UrbanSmartGrid/IRON_CASE_SWITCH/HW/PCB_PROJECTS/ACTUAL/MCAD/Параметры платы/6-слойная сборка Резонит.png

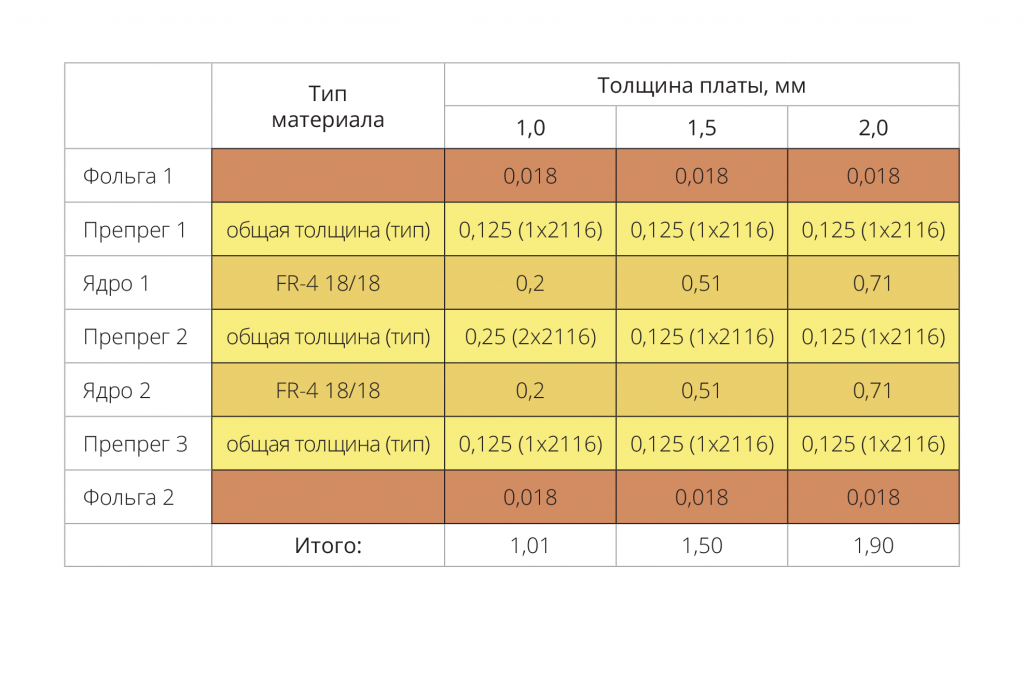
HW/PCB_PROJECTS/ACTUAL/MCAD/Параметры платы/6-слойная сборка Резонит.png
