UrbanSmartGrid/IRON_CASE_SWITCH/HW/PCB_PROJECTS/ACTUAL/MCAD/Исходные данные/MODULE_4x100_Fx/Плата MODULE_4x100_Fx.STEP

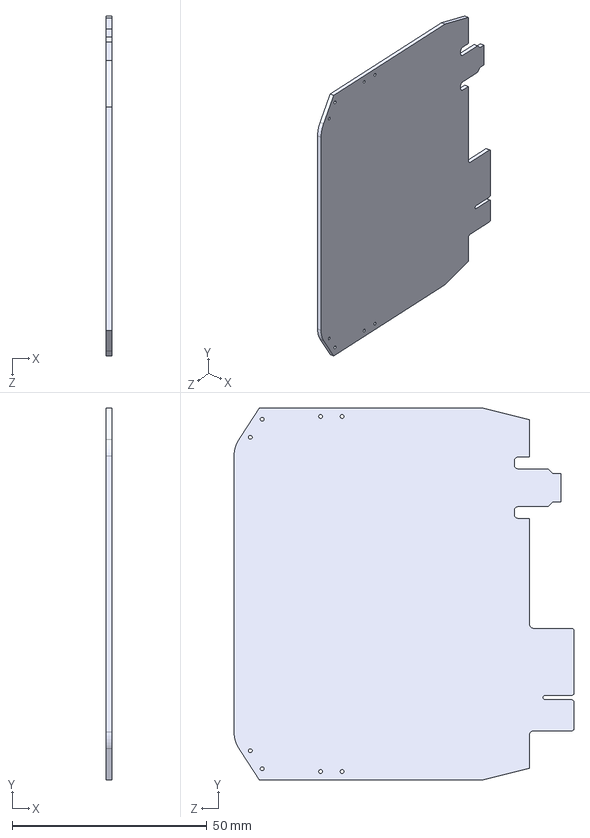
[picture p2: CAD file, 2021-02-21]
HW/PCB_PROJECTS/ACTUAL/MCAD/Исходные данные/MODULE_4x100_Fx/Плата MODULE_4x100_Fx.STEP
1.42 x 95.5 x 87.3 mm
