UrbanSmartGrid/IRON_CASE_SWITCH/HW/PCB_PROJECTS/ACTUAL/MCAD/Исходные данные/MOTHER_BOARD/Плата MOTHER_BOARD.STEP

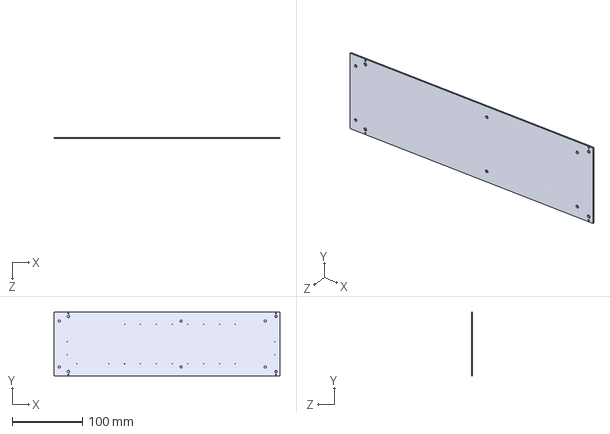
[picture p3: CAD file, 2021-02-21]
HW/PCB_PROJECTS/ACTUAL/MCAD/Исходные данные/MOTHER_BOARD/Плата MOTHER_BOARD.STEP
320.9 x 90.6 x 1.60 mm
