UrbanSmartGrid/IRON_CASE_SWITCH/HW/PCB_PROJECTS/ACTUAL/MCAD/Исходные данные/MODULE_4x100_Fx/WE 7466312.STEP

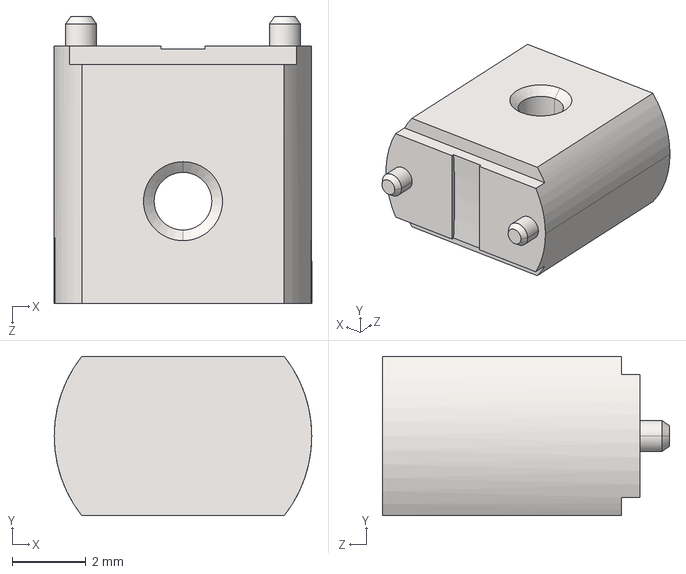
[picture p4: CAD file, 2021-02-21]
HW/PCB_PROJECTS/ACTUAL/MCAD/Исходные данные/MODULE_4x100_Fx/WE 7466312.STEP
7.00 x 4.33 x 7.80 mm
