UrbanSmartGrid/IRON_CASE_SWITCH/HW/PCB_PROJECTS/ACTUAL/MCAD/Исходные данные/MOTHER_BOARD/Направляющая печатной платы CGH-90.STEP

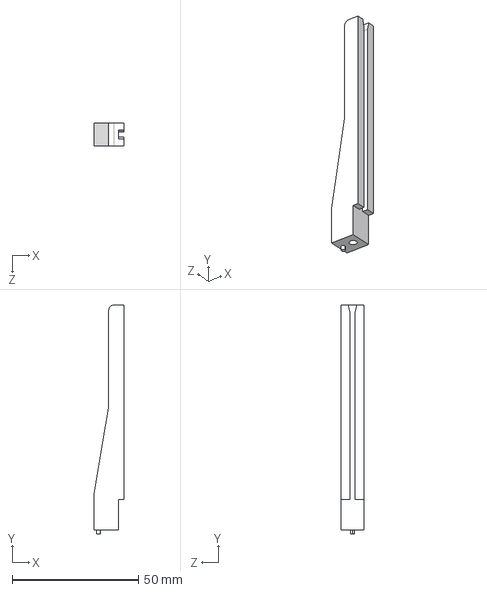
[picture p5: CAD file, 2021-02-21]
HW/PCB_PROJECTS/ACTUAL/MCAD/Исходные данные/MOTHER_BOARD/Направляющая печатной платы CGH-90.STEP
12.0 x 90.8 x 9.00 mm
