UrbanSmartGrid/IRON_CASE_SWITCH/HW/PCB_PROJECTS/ACTUAL/MCAD/Исходные данные/MOTHER_BOARD/Плата MOTHER_BOARD исх. дан..PDF

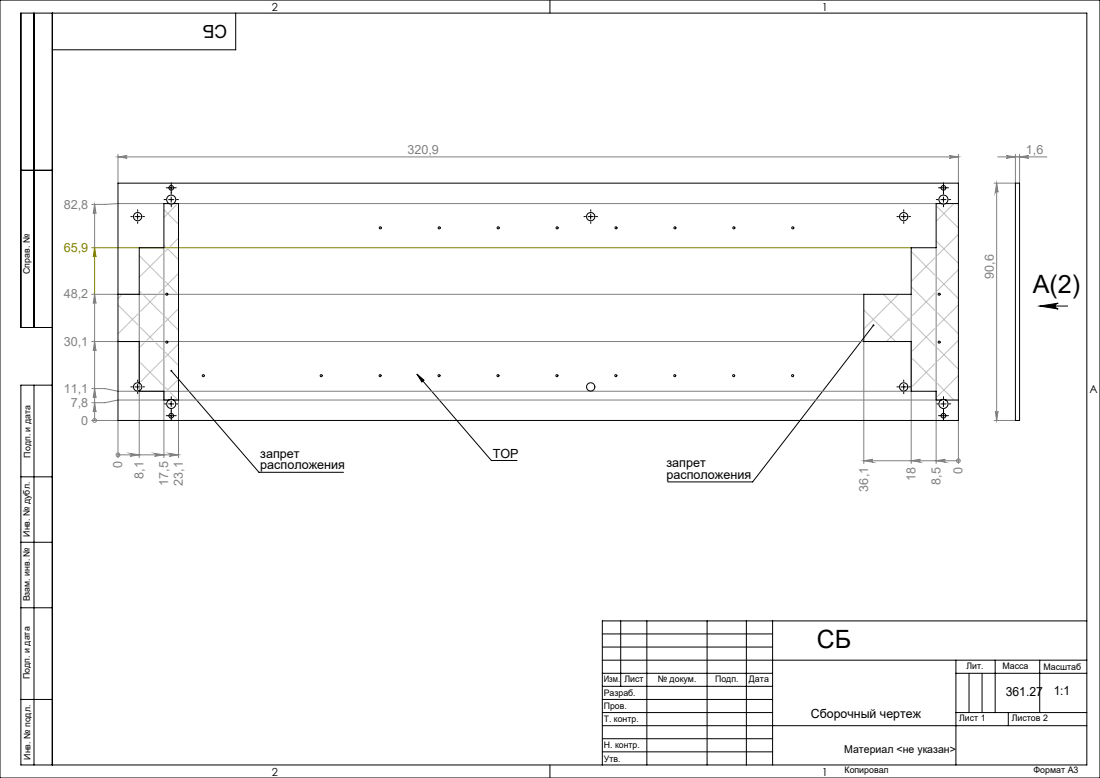
[picture p6: page 1]
Копировал; Формат А3

Справ. № Подп. и дата Инв. № дубл. Взам. инв. № Подп. и дата Инв. № подл.

Сборочный чертеж | Лит. | Масса | Масштаб

Изм. | Лист | № докум. | Подп. | Дата | | | | | 361.27 | 1:1
Разраб.
Пров.
Т. контр. | | | | | Лист 1 | Листов 2

Н. контр.
Утв.

Материал <не указан>

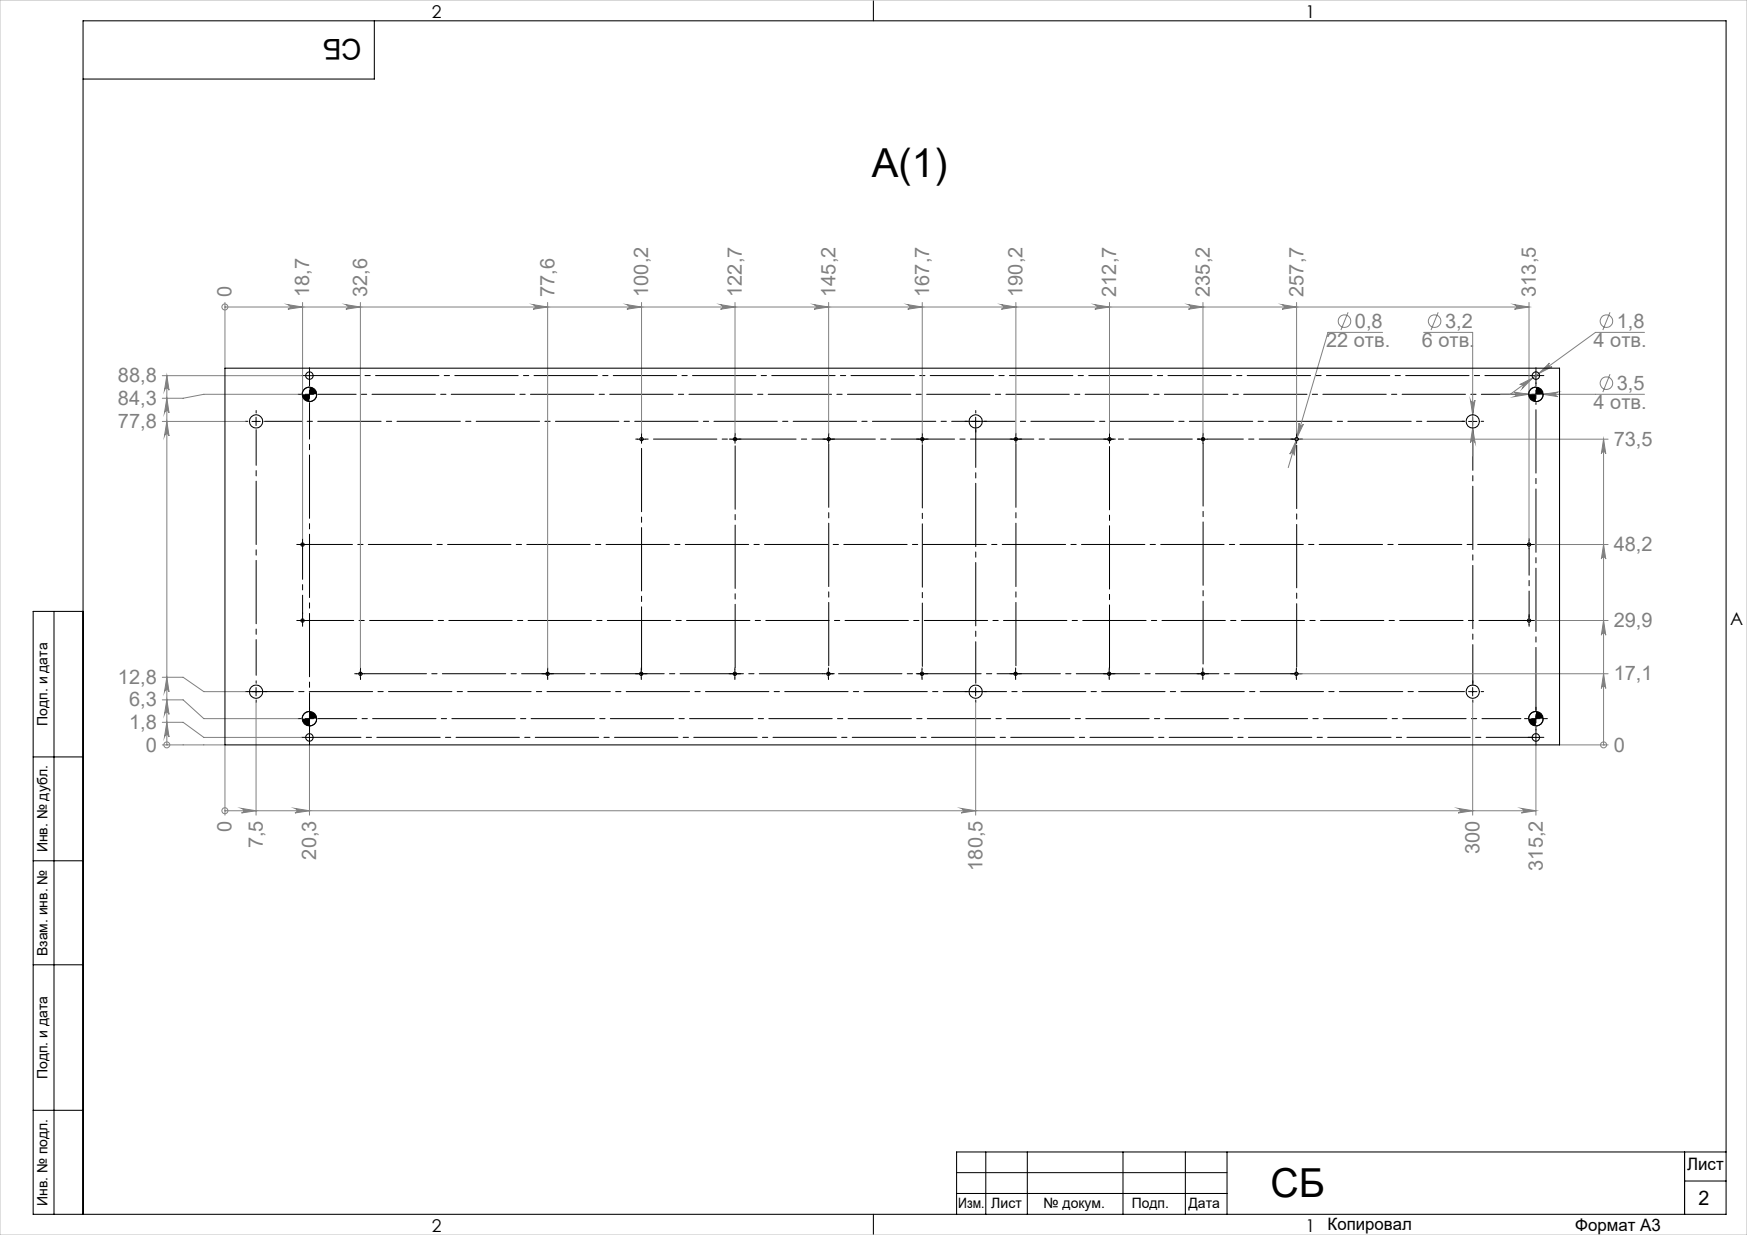
[picture p7: page 2]
4 отв.; Инв. № подл.; № докум.; Подп.; Дата; Формат А3

0,8 3,2 22 отв. 6 отв.

Подп. и дата Взам. инв. № Инв. № дубл. Подп. и дата
