UrbanSmartGrid/IRON_CASE_SWITCH/HW/PCB_PROJECTS/LEGACY/SWITCH_34/Version1/MODULE_4x100_RJ45/MODULE_4x100_RJ45_V1.0.pdf

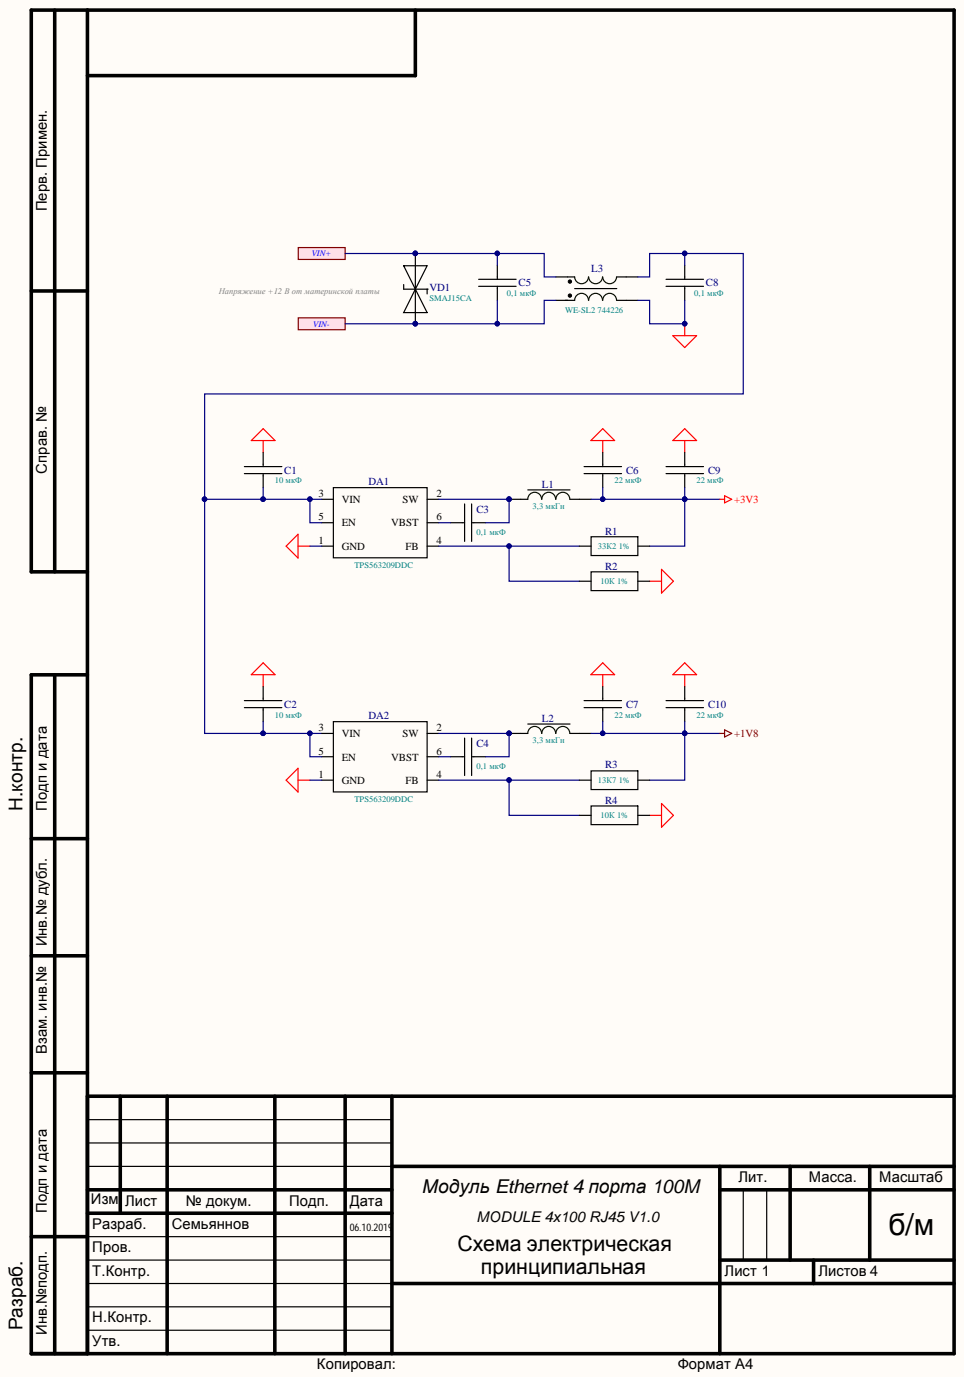
[picture p8: page 1]

Подп и дата Перв. Примен. Справ. №

C8 0,1 мкФ VD1 SMAJ15CA Напряжение +12 В от материнской платы

Инв.№подп. Инв.№ дубл. Подп и дата Взам. инв.№

06.10.2019 б/м | Модуль Ethernet 4 порта 100M MODULE 4x100 RJ45 V1.0 Схема электрическая принципиальная | Лит. | Масса. | Масштаб

Изм. | Лист | № докум. | Подп. | Дата
Разраб. | | Семьяннов
Пров.
Т.Контр. | | | | | Лист 1 | Листов 4

Н.Контр.
Утв.

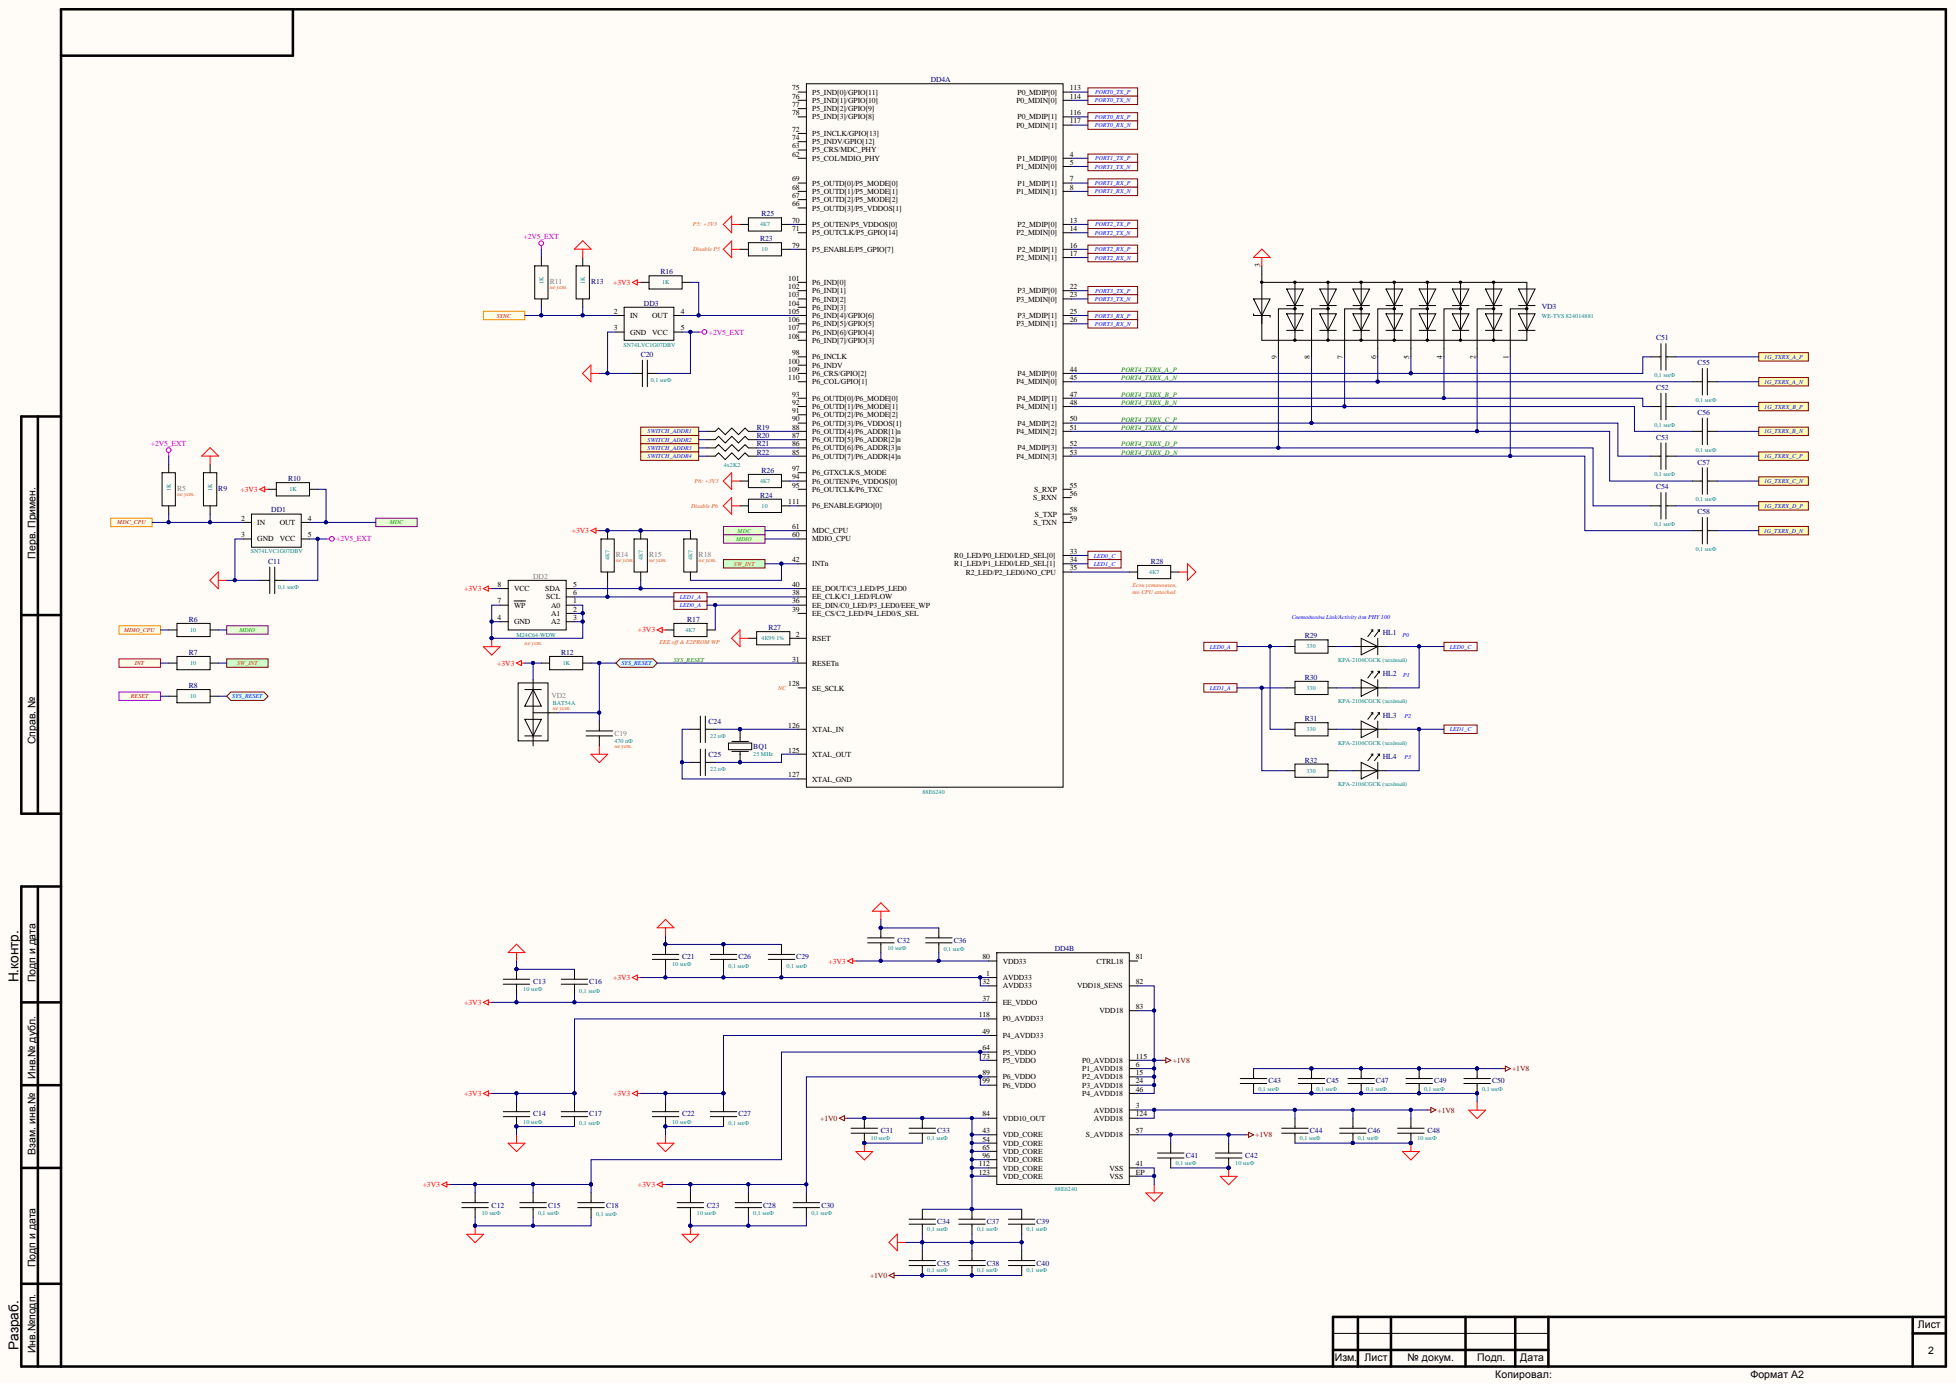
[picture p9: page 2]

Подп и дата Перв. Примен. Справ. №

0,1 мкФ

Светодиоды Link/Activity для PHY 100

330 | KPA-2106CGCK (зелёный) | HL4 P3 | LED1_C

Инв.№подп. Инв.№ дубл. Подп и дата Взам. инв.№

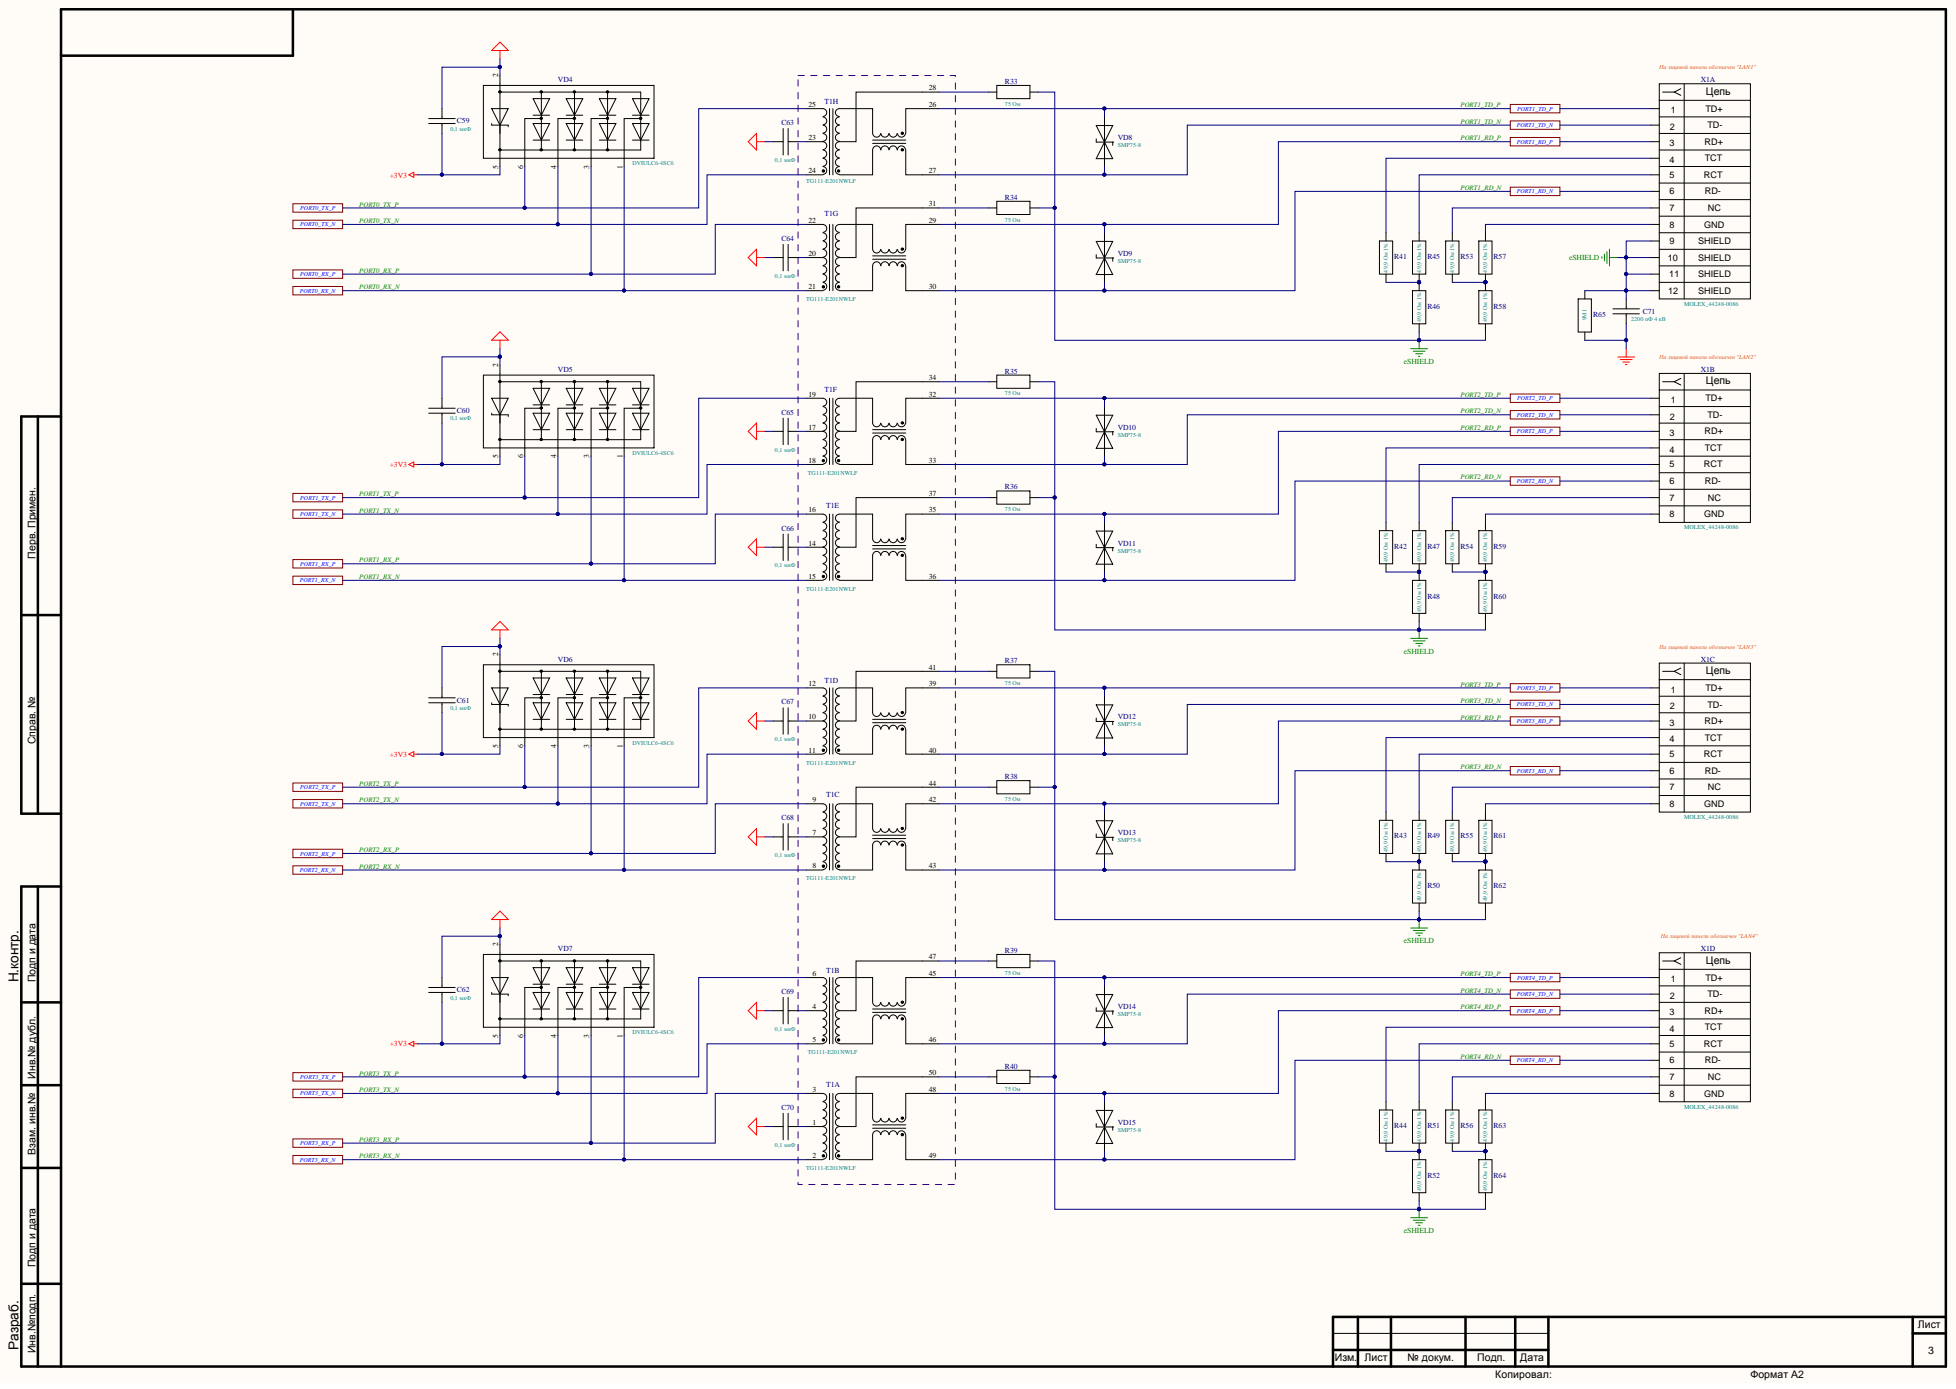
[picture p10: page 3]

12345678 | SHIELD X1A RD+
TD+ TD- TCT

Цепь

RCT

10 | SHIELD SHIELD SHIELD

GND X1B TD+ TD- TCT

Подп и дата Перв. Примен. Справ. №

GND X1C TD+ TD- TCT

GND X1D TD+ TD- TCT

Инв.№подп. Инв.№ дубл. Подп и дата Взам. инв.№

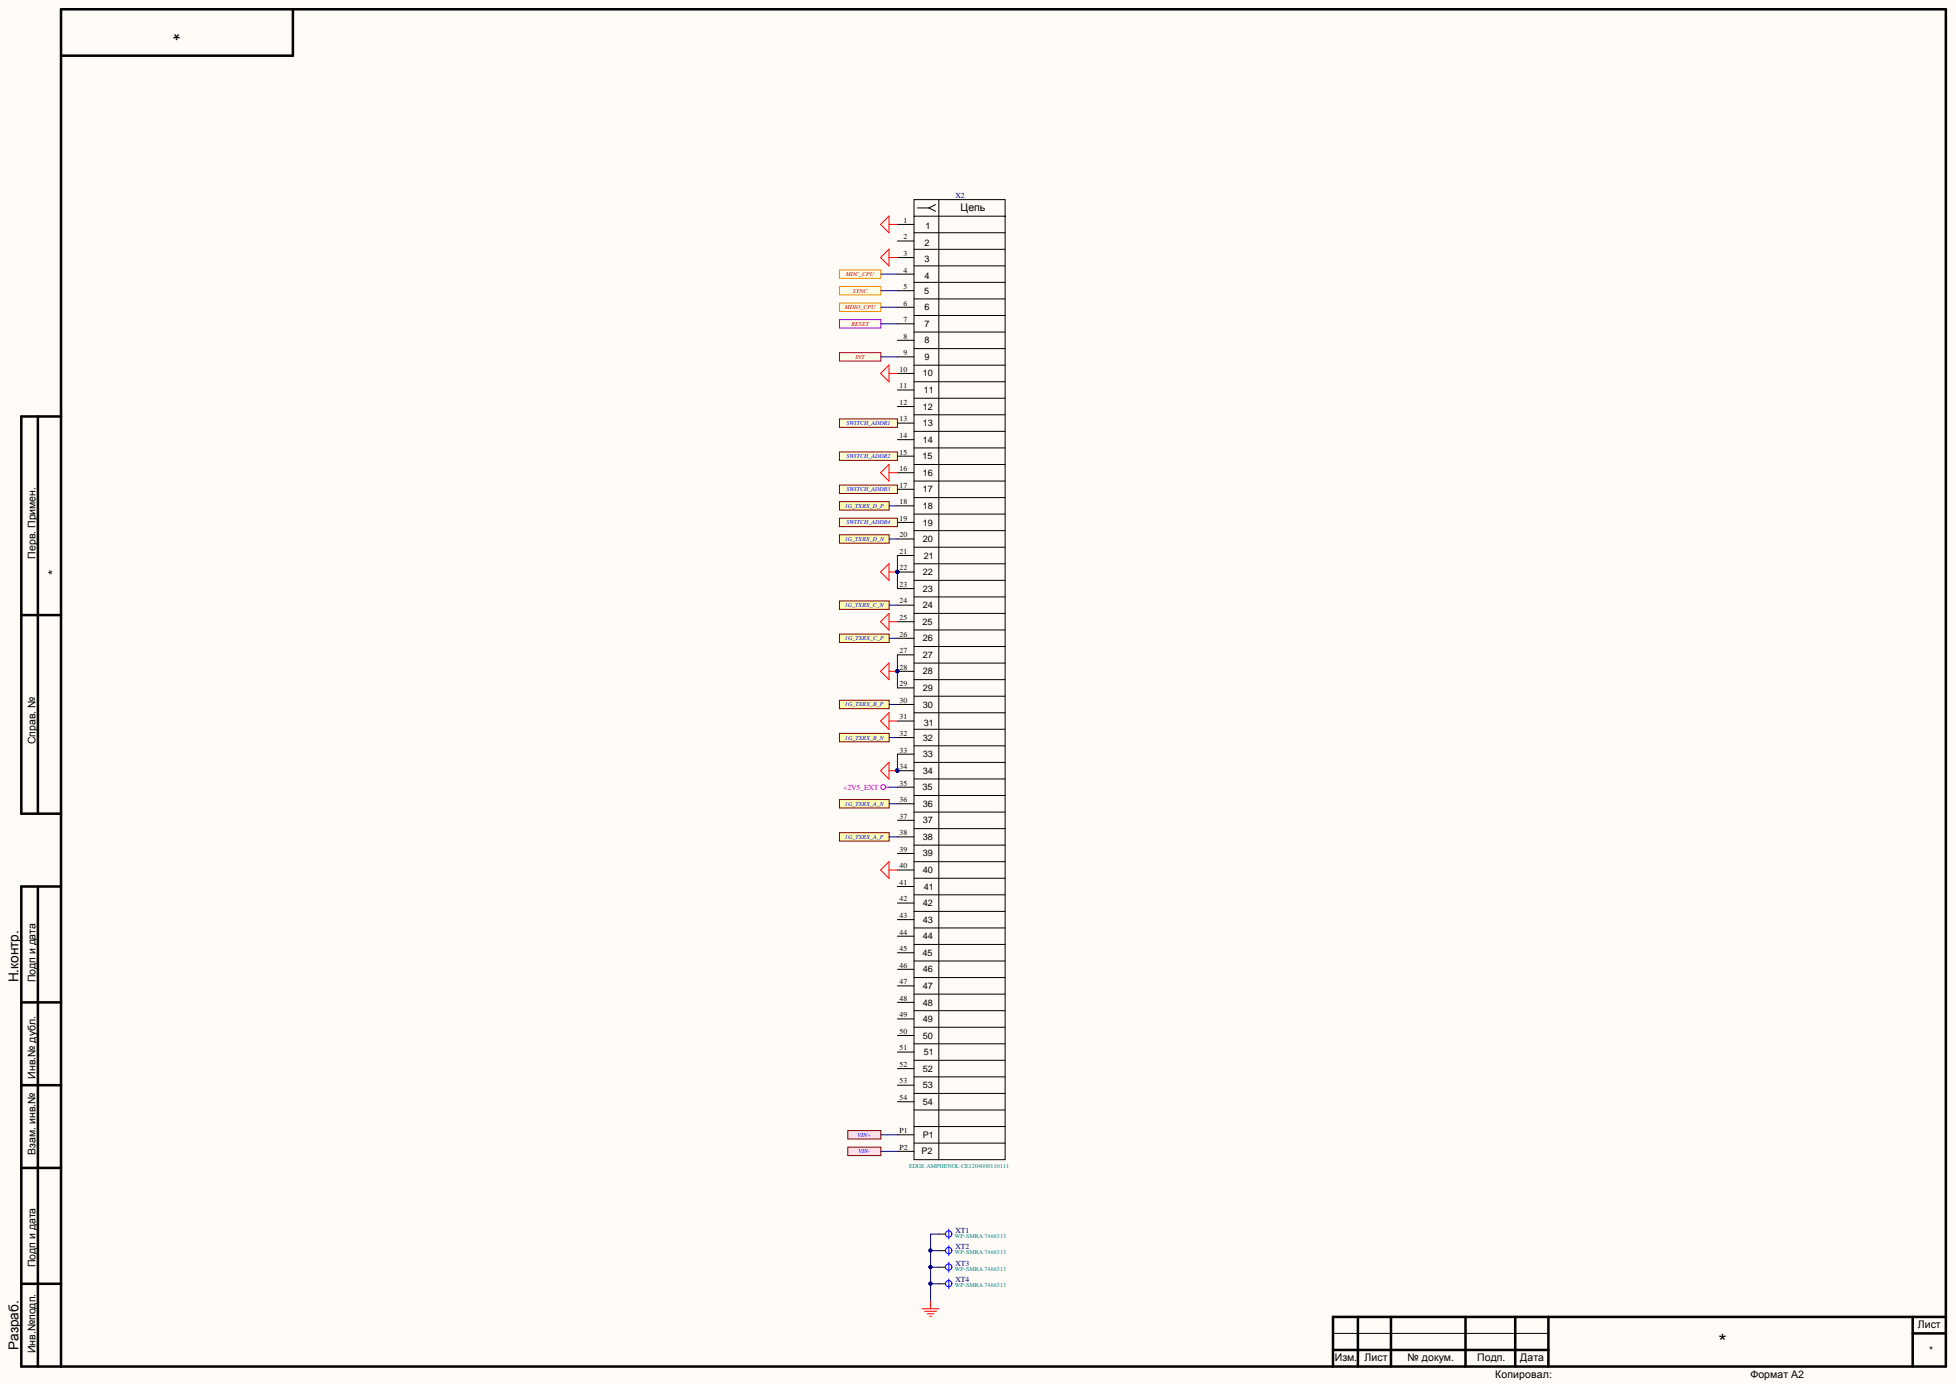
[picture p11: page 4]

Цепь

Подп и дата Перв. Примен. Справ. №

31
32

Инв.№подп. Инв.№ дубл. Подп и дата Взам. инв.№
