UrbanSmartGrid/IRON_CASE_SWITCH/HW/PCB_PROJECTS/LEGACY/SWITCH_34/Version1/MODULE_CONTROL/MODULE_CONTROL_V1.0.pdf

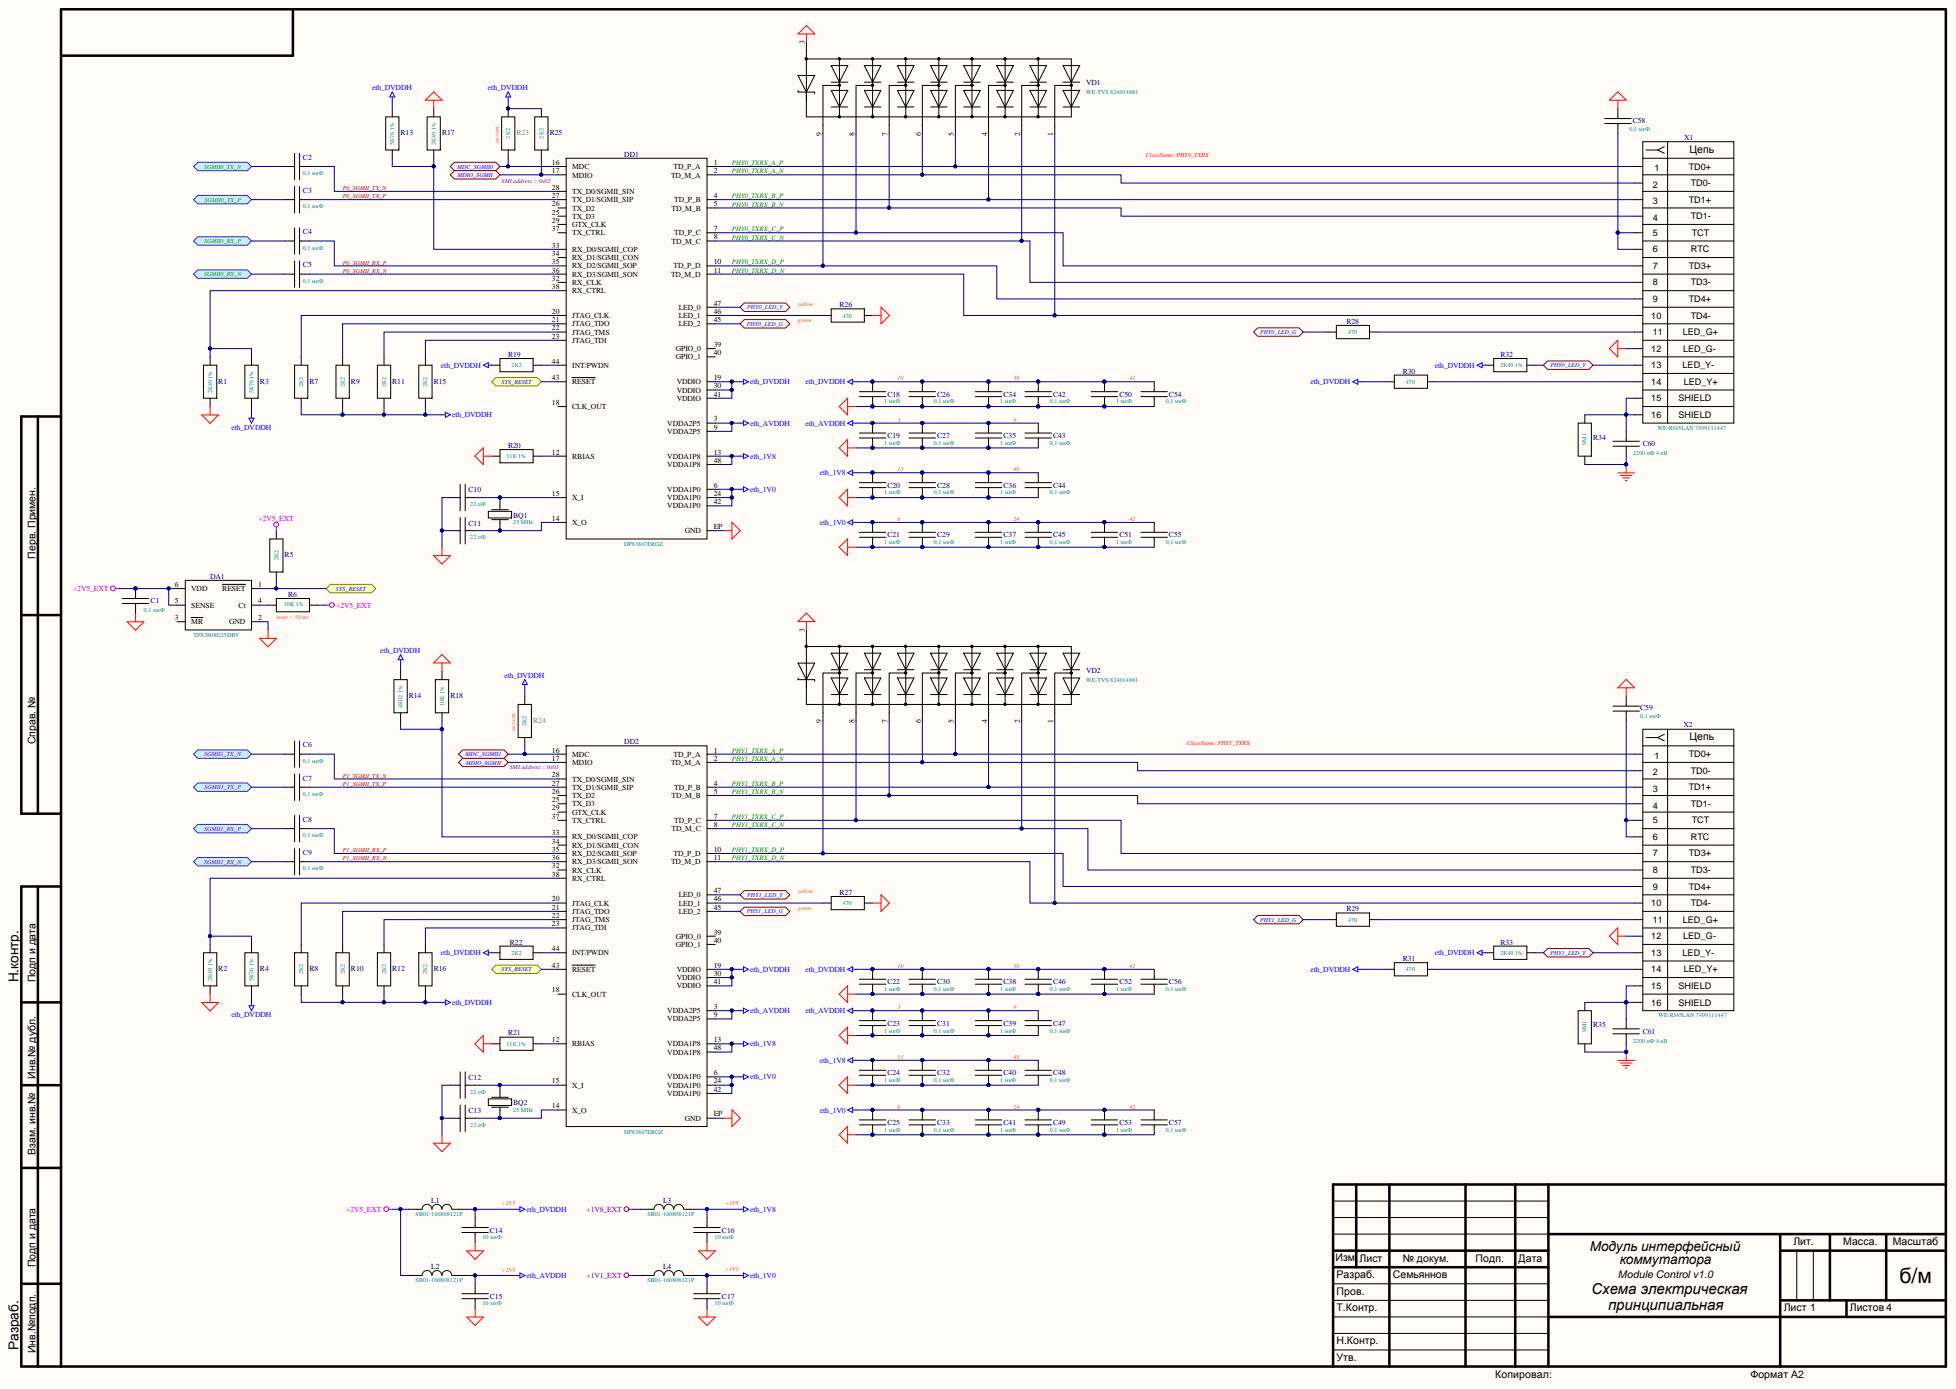
[picture p12: page 1]

мкФ P0 _ SGMII_ TX_N | 1 | 7 | 2 P H Y0_TXR X_A_N

2 2 2 3 | 6 5 9 7 | 5 P H Y0_TXR X_B_N

8 P H Y0_TXR X_C_N

P0 _ SGMII_RX_ P | 3 | 3 | 1 0 P H Y0_TXR X_D_P | RT C

Подп и дата Перв. Примен. Справ. №

мкФ P1 _ SGMII_ TX_N | 1 MDIO_ SGMII | 7 | 2 P H Y1_TXR X_A_N

2 2 2 3 | 6 5 9 7 | 5 P H Y1_TXR X_B_N

TD1- TCT TD3+ TD3-

8 P H Y1_TXR X_C_N

P1 _ SGMII_RX_ P | 3 | 3 | 1 0 P H Y1_TXR X_D_P | RT C

4 7 y ello

Инв.№подп. Инв.№ дубл. Подп и дата Взам. инв.№

Изм | . Лис т | № д оку м . | П о д п . | Дата | б / м
Разр а б . | | Се мьян н о в

Н . К о нтр .
Утв .

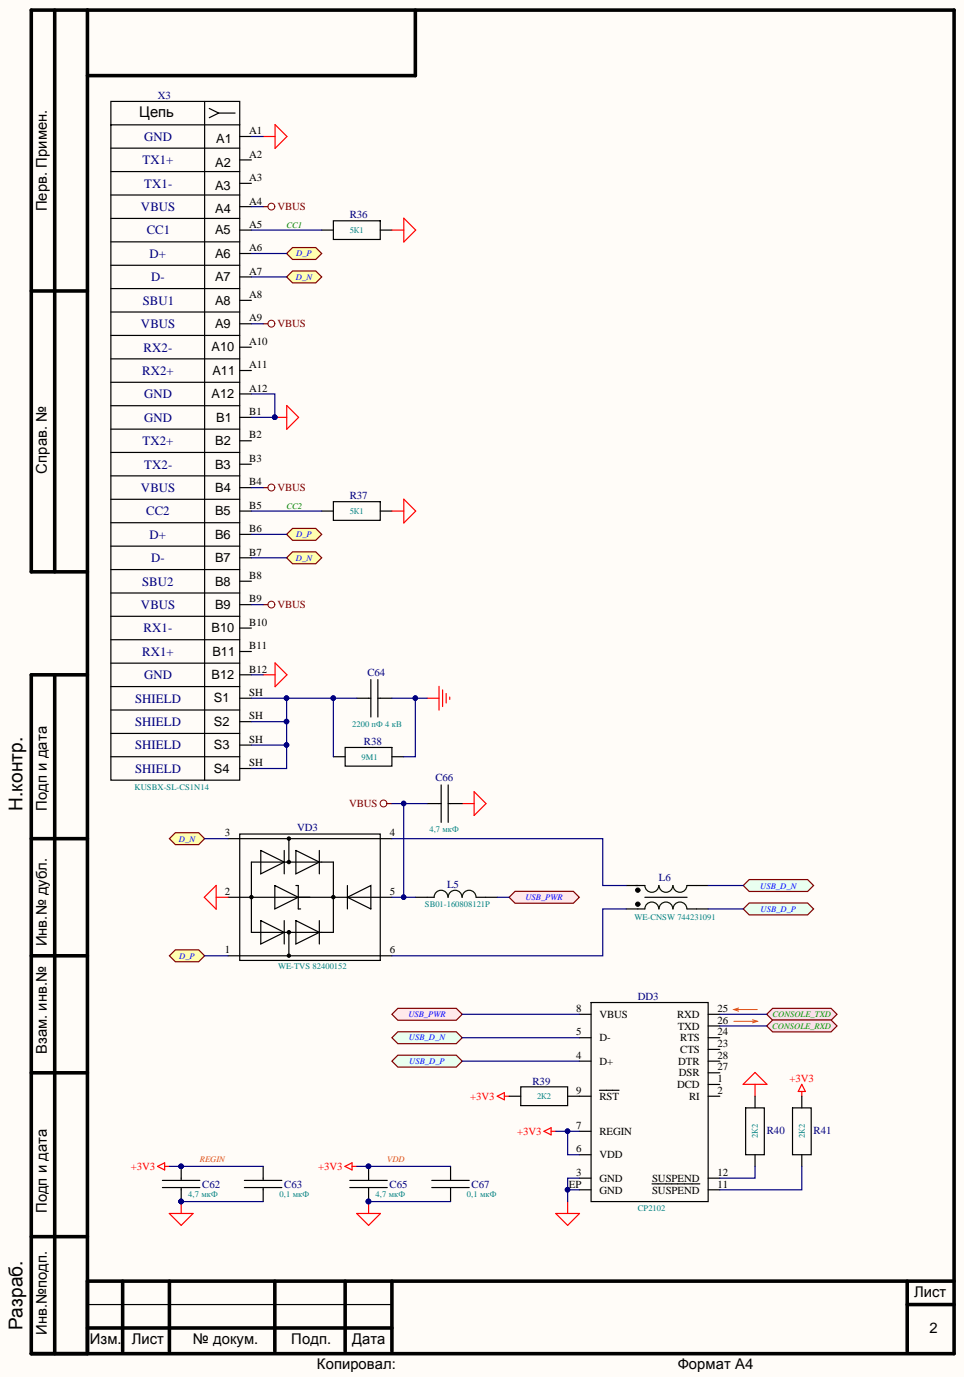
[picture p13: page 2]

Подп и дата Перв. Примен. Справ. №

Цепь

GND | A1

VBUS | A4

SBU1 | A8

VBUS | A9

GND | A12

GND | B1

VBUS | B4

SBU2 | B8

VBUS | B9

GND | B12

SHIELD | S1

SHIELD | S2

SHIELD | S3

SHIELD | S4

Инв.№подп. Инв.№ дубл. Подп и дата Взам. инв.№

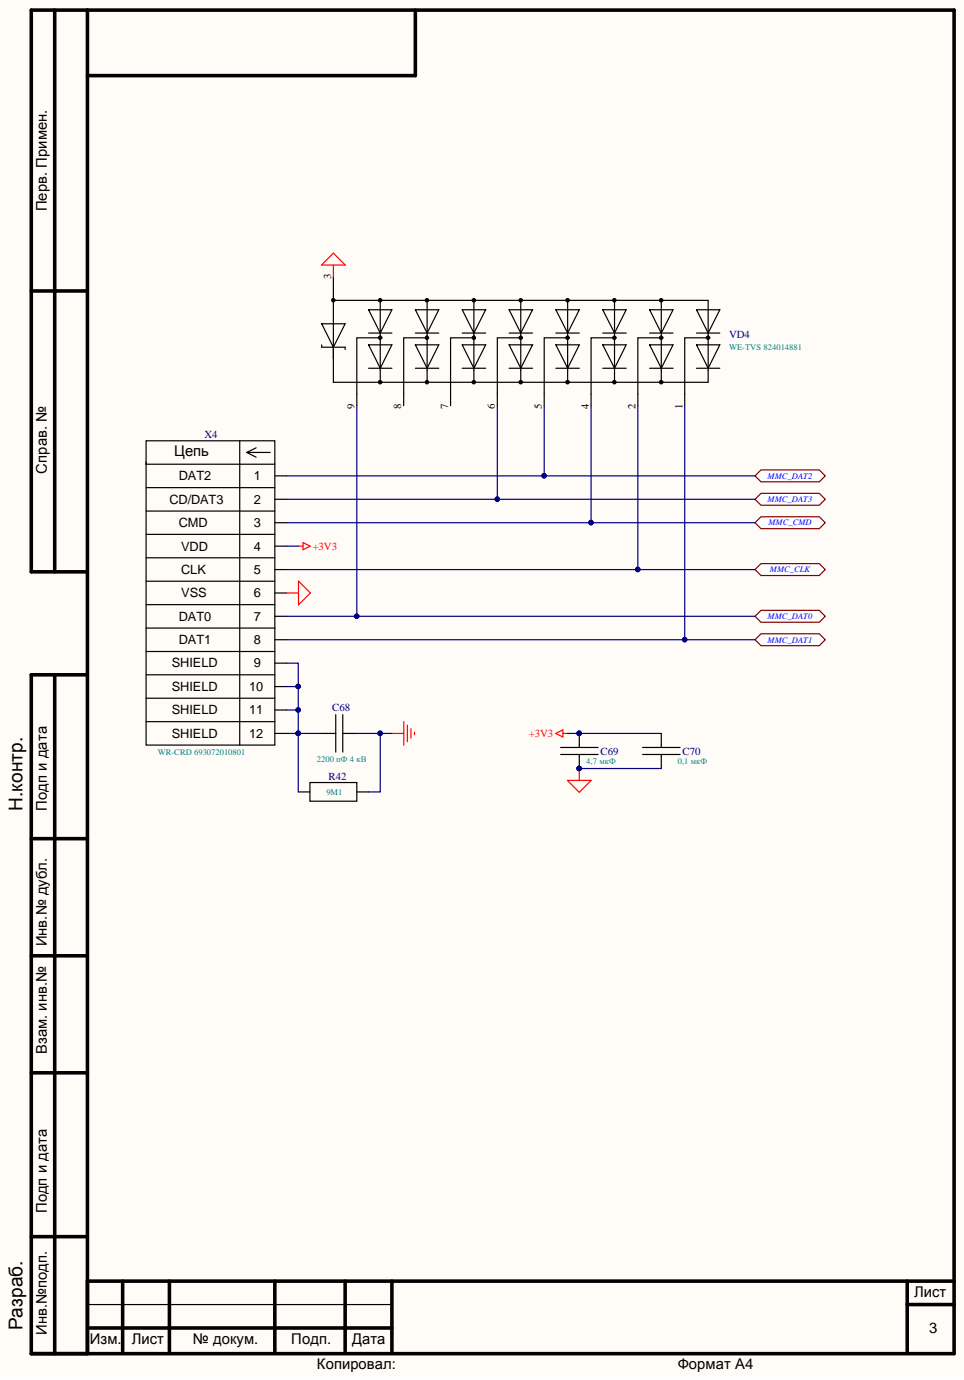
[picture p14: page 3]

Подп и дата Перв. Примен. Справ. №

Цепь

DAT2 | 1

CD/DAT3 | 2

CMD | 3

VDD | 4

CLK | 5

VSS | 6

DAT0 | 7

DAT1 | 8

SHIELD | 9

SHIELD | 10

SHIELD | 11

SHIELD | 12

Инв.№подп. Инв.№ дубл. Подп и дата Взам. инв.№

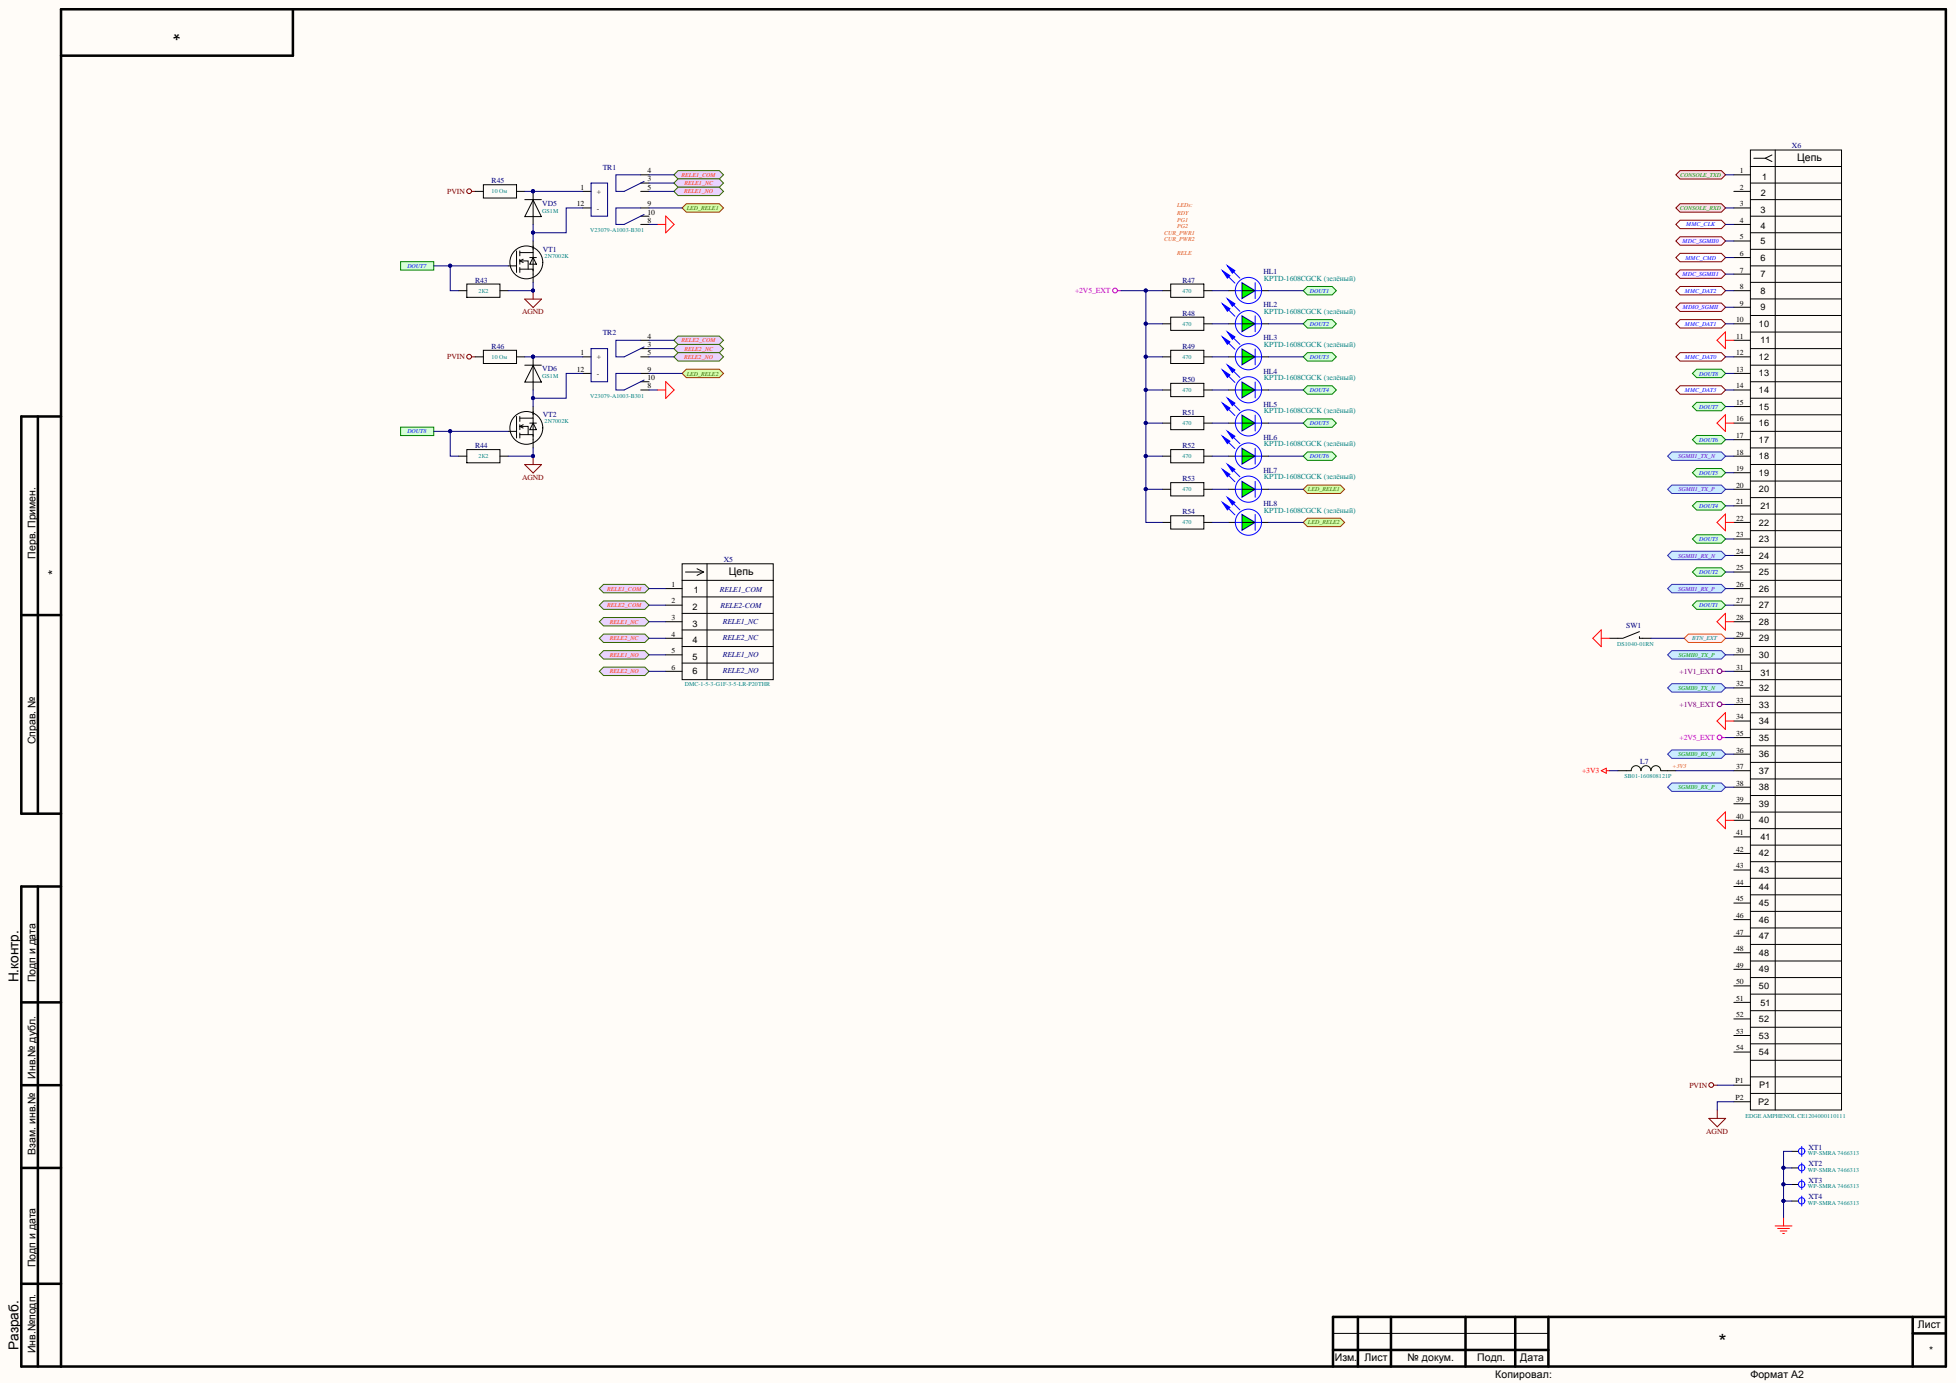
[picture p15: page 4]

Подп и дата Перв. Примен. Справ. №

Инв.№подп. Инв.№ дубл. Подп и дата Взам. инв.№
