UrbanSmartGrid/IRON_CASE_SWITCH/HW/PCB_PROJECTS/LEGACY/SWITCH_34/Version1/MOTHER_BOARD/MOTHER_BOARD_LS1021_v1.0.pdf

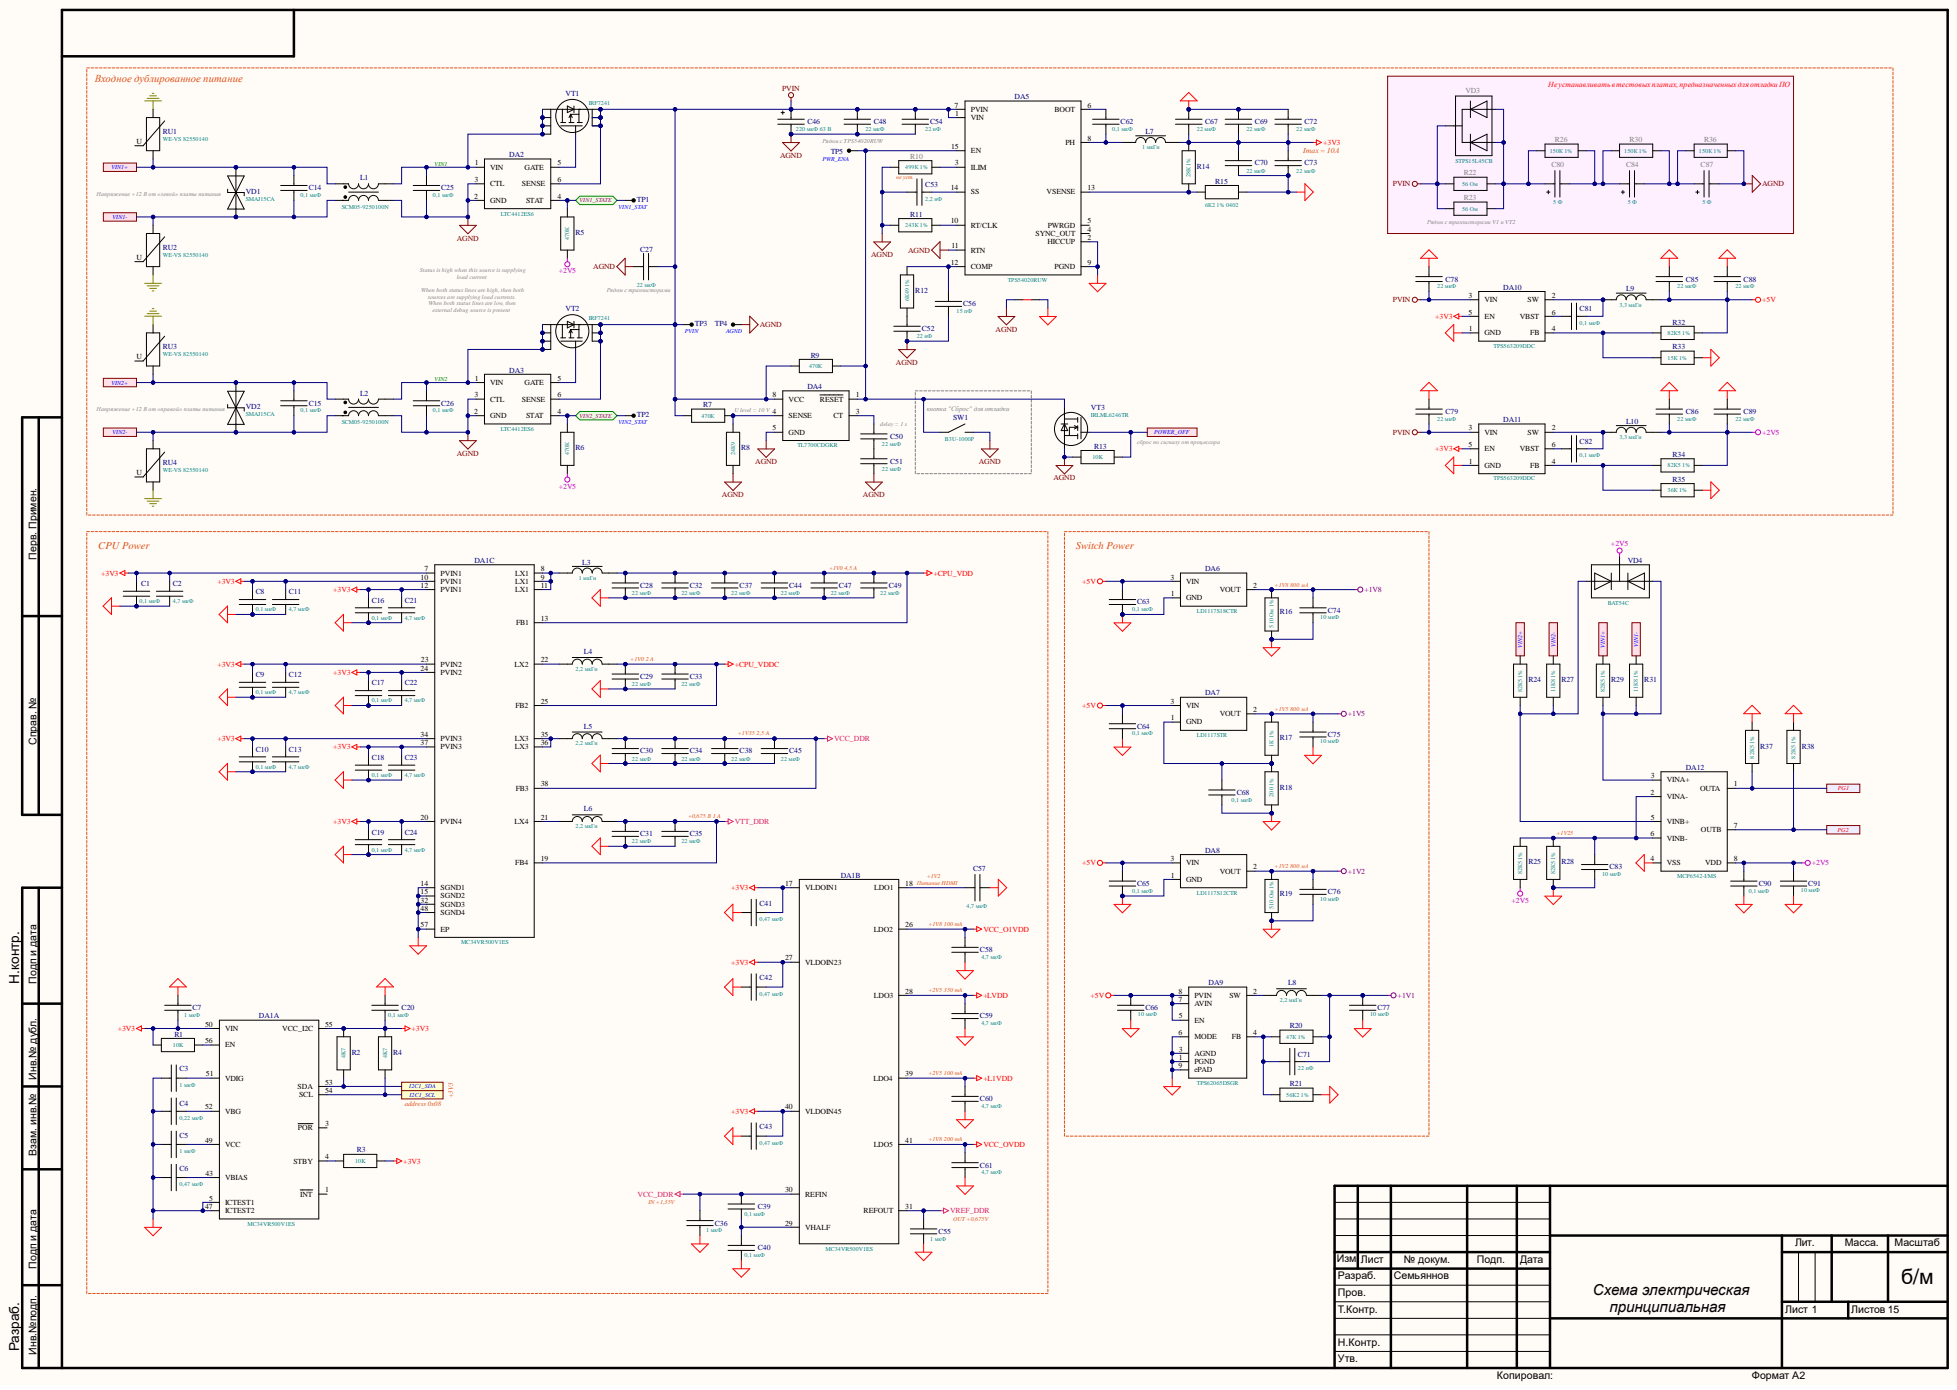
[picture p16: page 1]

Не устанавливать в тестовых платах, предназначенных для отладки ПО

Напряжение +12 В от «левой» платы питания

Status is high when this source is supplying

When both status lines are high, then both
sources are supplying load currents.
When both status lines are low, then
external debug source is present

кнопка "Сброс" для отладки

POWER_OFF
сброс по сигналу от процессора

Подп и дата Перв. Примен. Справ. №

BAT54C

2,2 мкГн

Инв.№подп. Инв.№ дубл. Подп и дата Взам. инв.№

Схема электрическая принципиальная | Лит. | Масса. | Масштаб

Изм. | Лист | № докум. | Подп. | Дата | | | | | б/м
Разраб. | | Семьяннов
Пров.
Т.Контр. | | | | | Лист 1 | Листов 15

Н.Контр.
Утв.

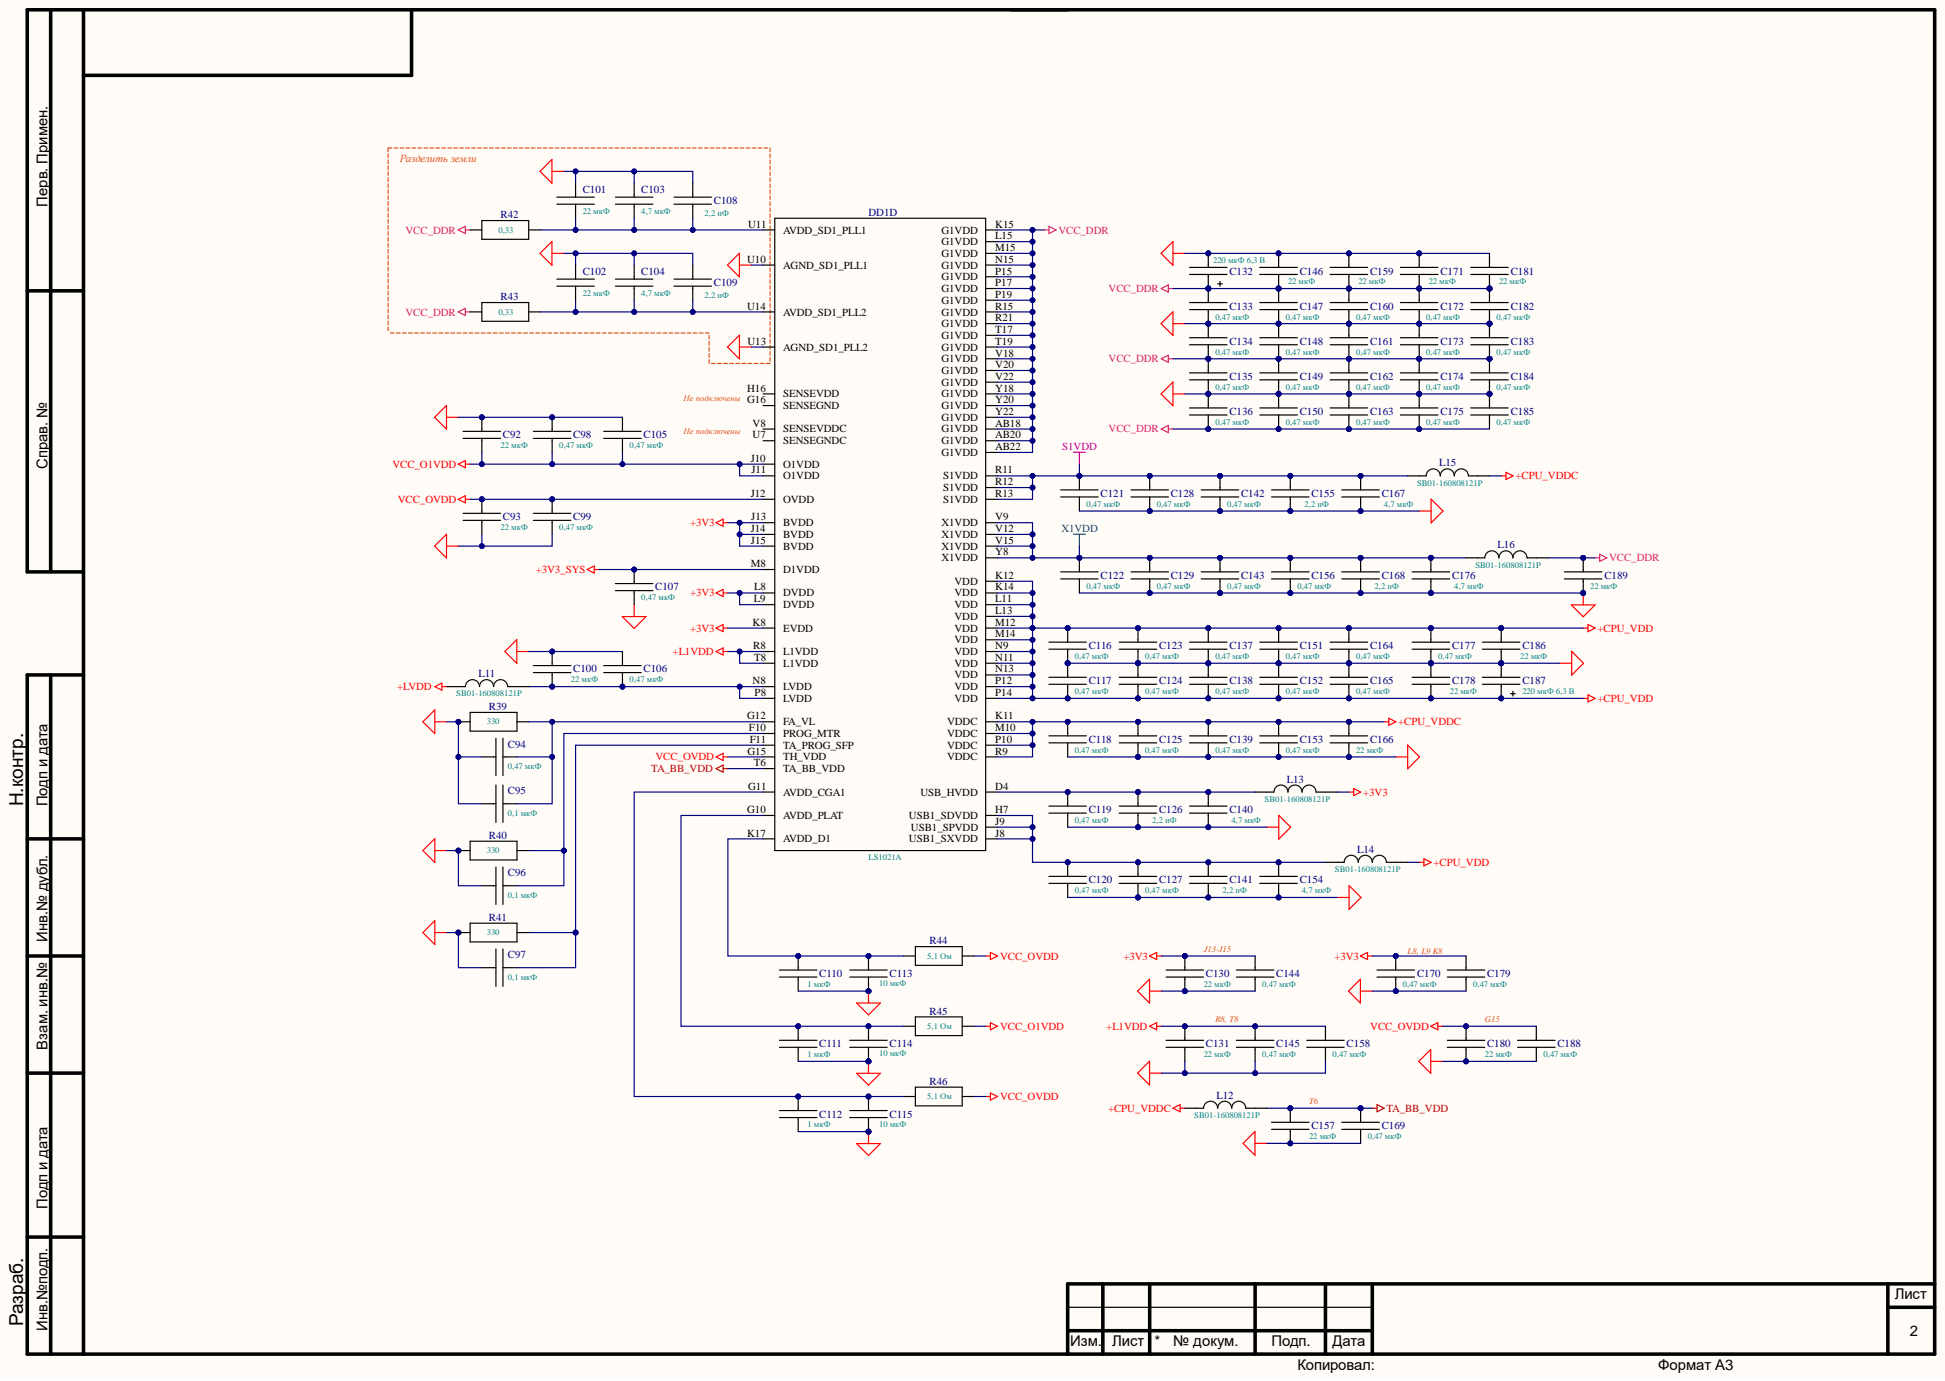
[picture p17: page 2]

Подп и дата Перв. Примен. Справ. №

VCC_OVDD TA_BB_VDD | | TH_VDD G15

TA_BB_VDD T6 | C126 C140 C154

Инв.№подп. Инв.№ дубл. Подп и дата Взам. инв.№

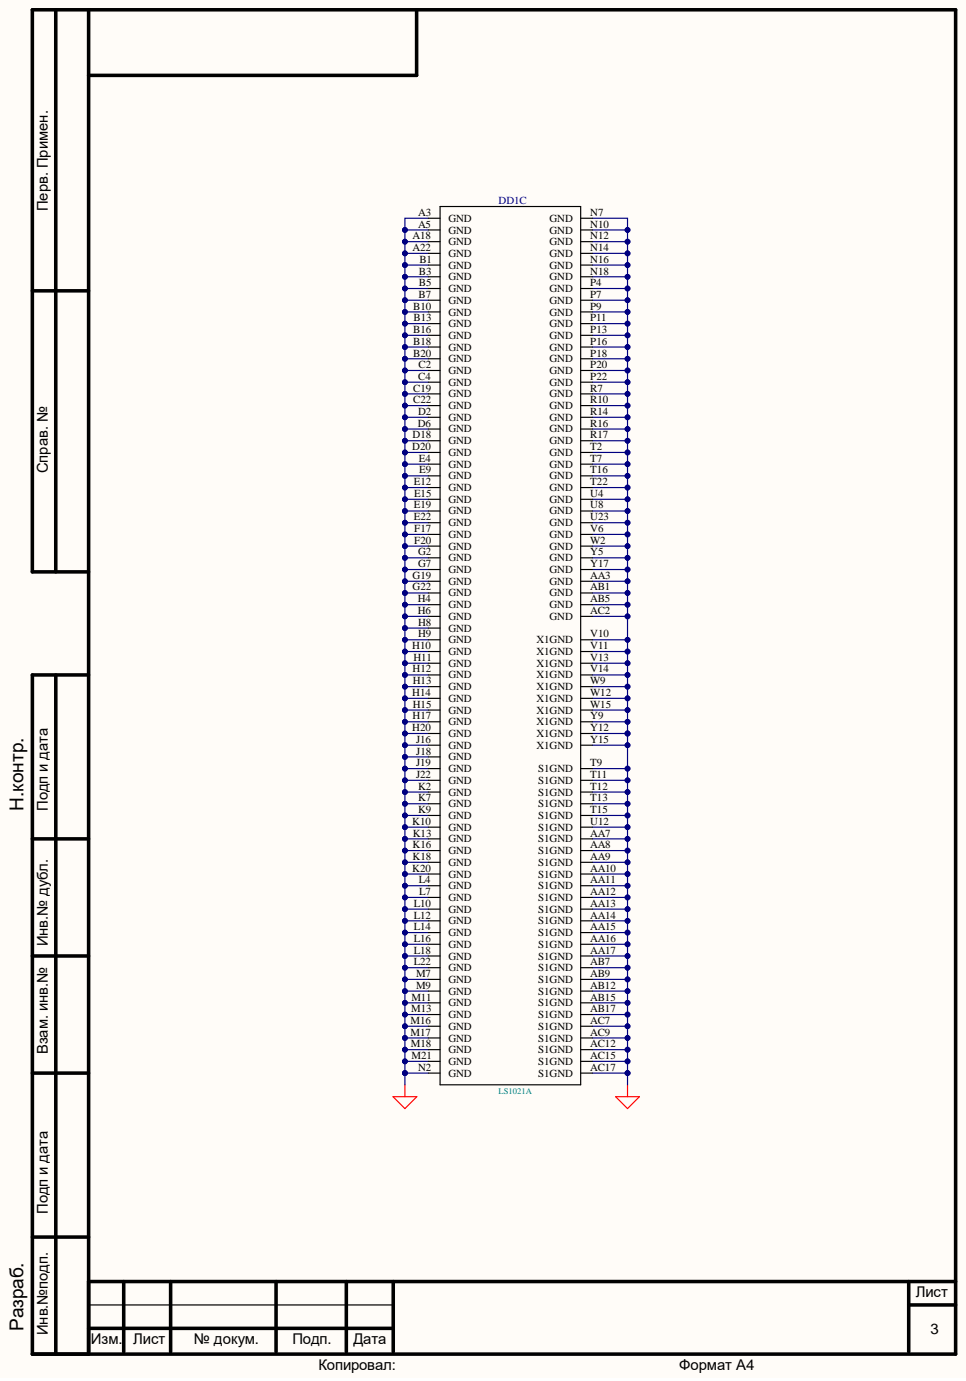
[picture p18: page 3]

Подп и дата Перв. Примен. Справ. №

Инв.№подп. Инв.№ дубл. Подп и дата Взам. инв.№

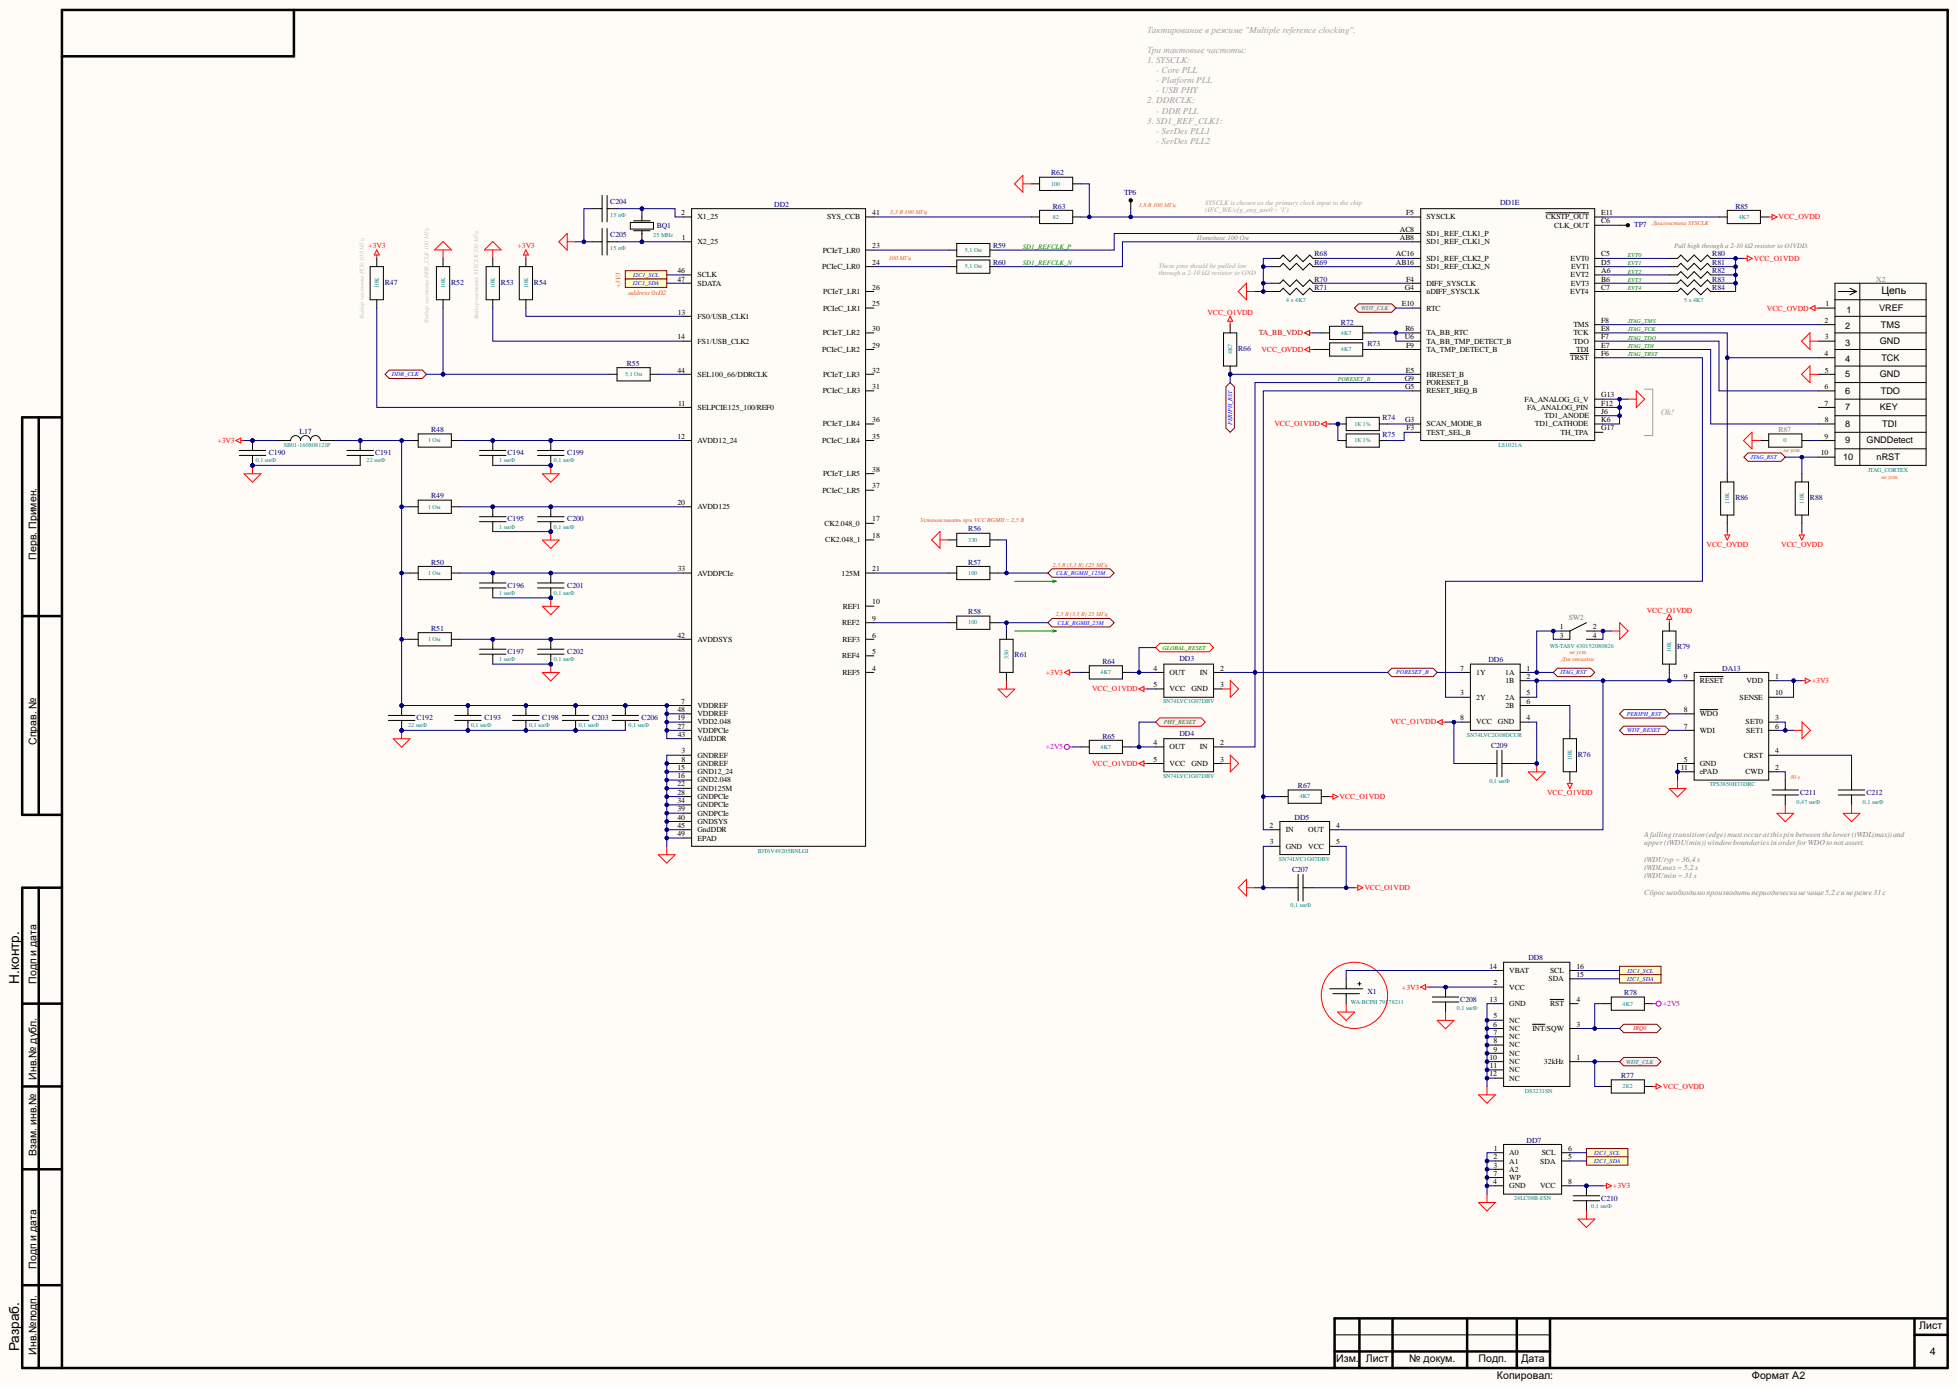
[picture p19: page 4]

Тактирование в режиме "Multiple reference clocking".

SYSCLK is chosen as the primary clock input to the chip
(IFC_WE/cfg_eng_use0 = '1')

Выбор частоты PCIe 100 МГц

Выбор частоты SYSCLK 100 МГц

R59 5,1 Ом SD1_REFCLK_P R68

Pull high through a 2-10 kΩ resistor to O1VDD.

These pins should be pulled low
through a 2-10 kΩ resistor to GND

1 | VREF

2 | TMS

JTAG_TDO | | 3 | GND

4 | TCK

Подп и дата Перв. Примен. Справ. №

Устанавливать при VCC RGMII = 2,5 В

A falling transition (edge) must occur at this pin between the lower(tWDL(max)) and
upper(tWDU(min)) windowboundariesin orderfor WDO to not assert.

Сброс необходимо производить периодически не чаще 5,2 с и не реже 31 с

Инв.№подп. Инв.№ дубл. Подп и дата Взам. инв.№

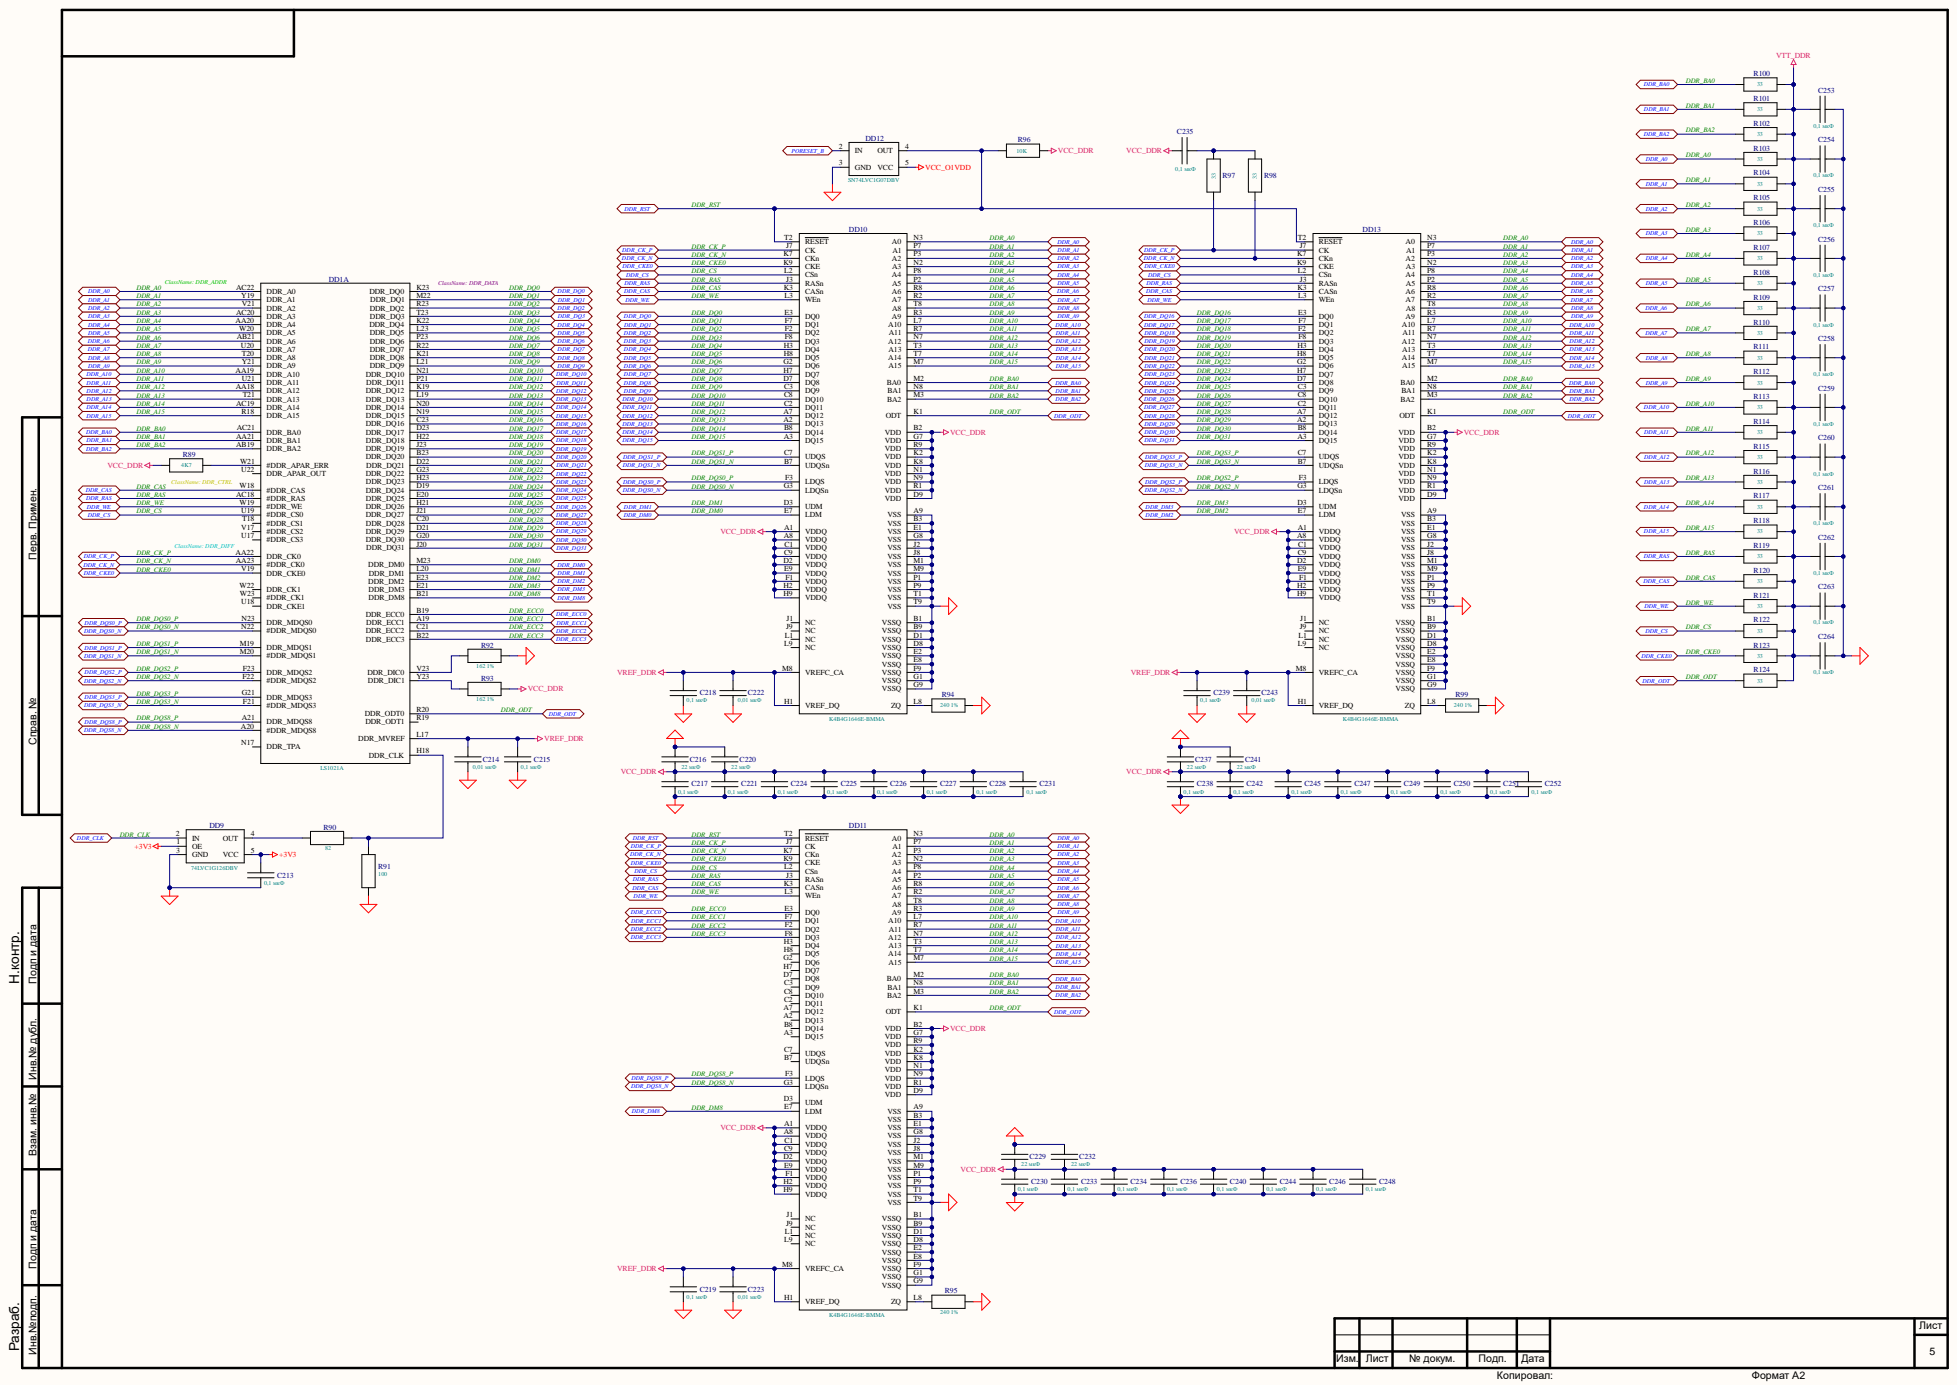
[picture p20: page 5]

Подп и дата Перв. Примен. Справ. №

Инв.№подп. Инв.№ дубл. Подп и дата Взам. инв.№

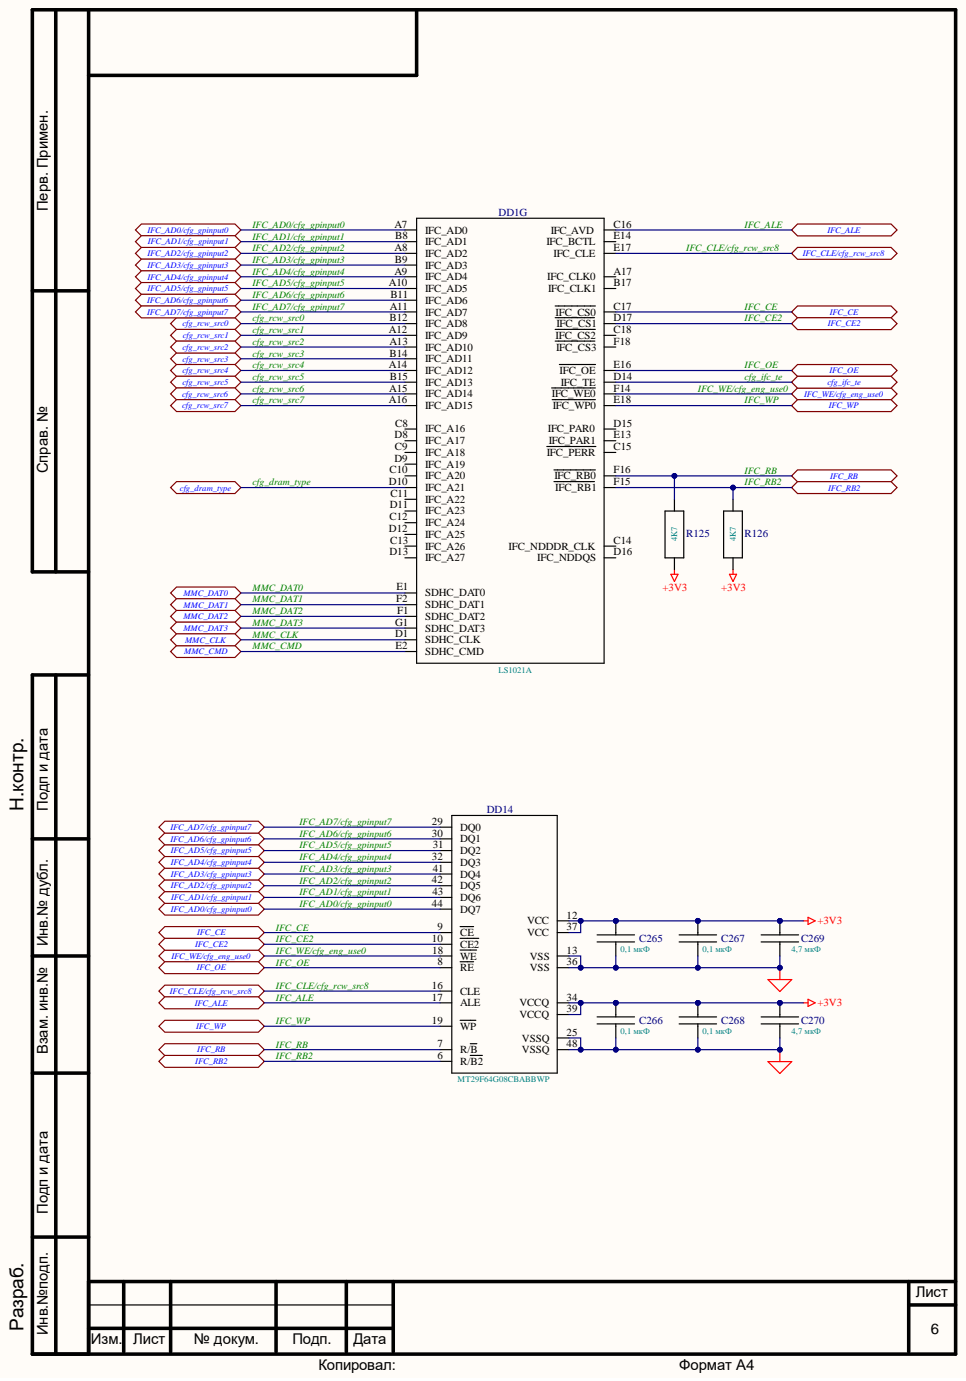
[picture p21: page 6]

Подп и дата Перв. Примен. Справ. №

Инв.№подп. Инв.№ дубл. Подп и дата Взам. инв.№

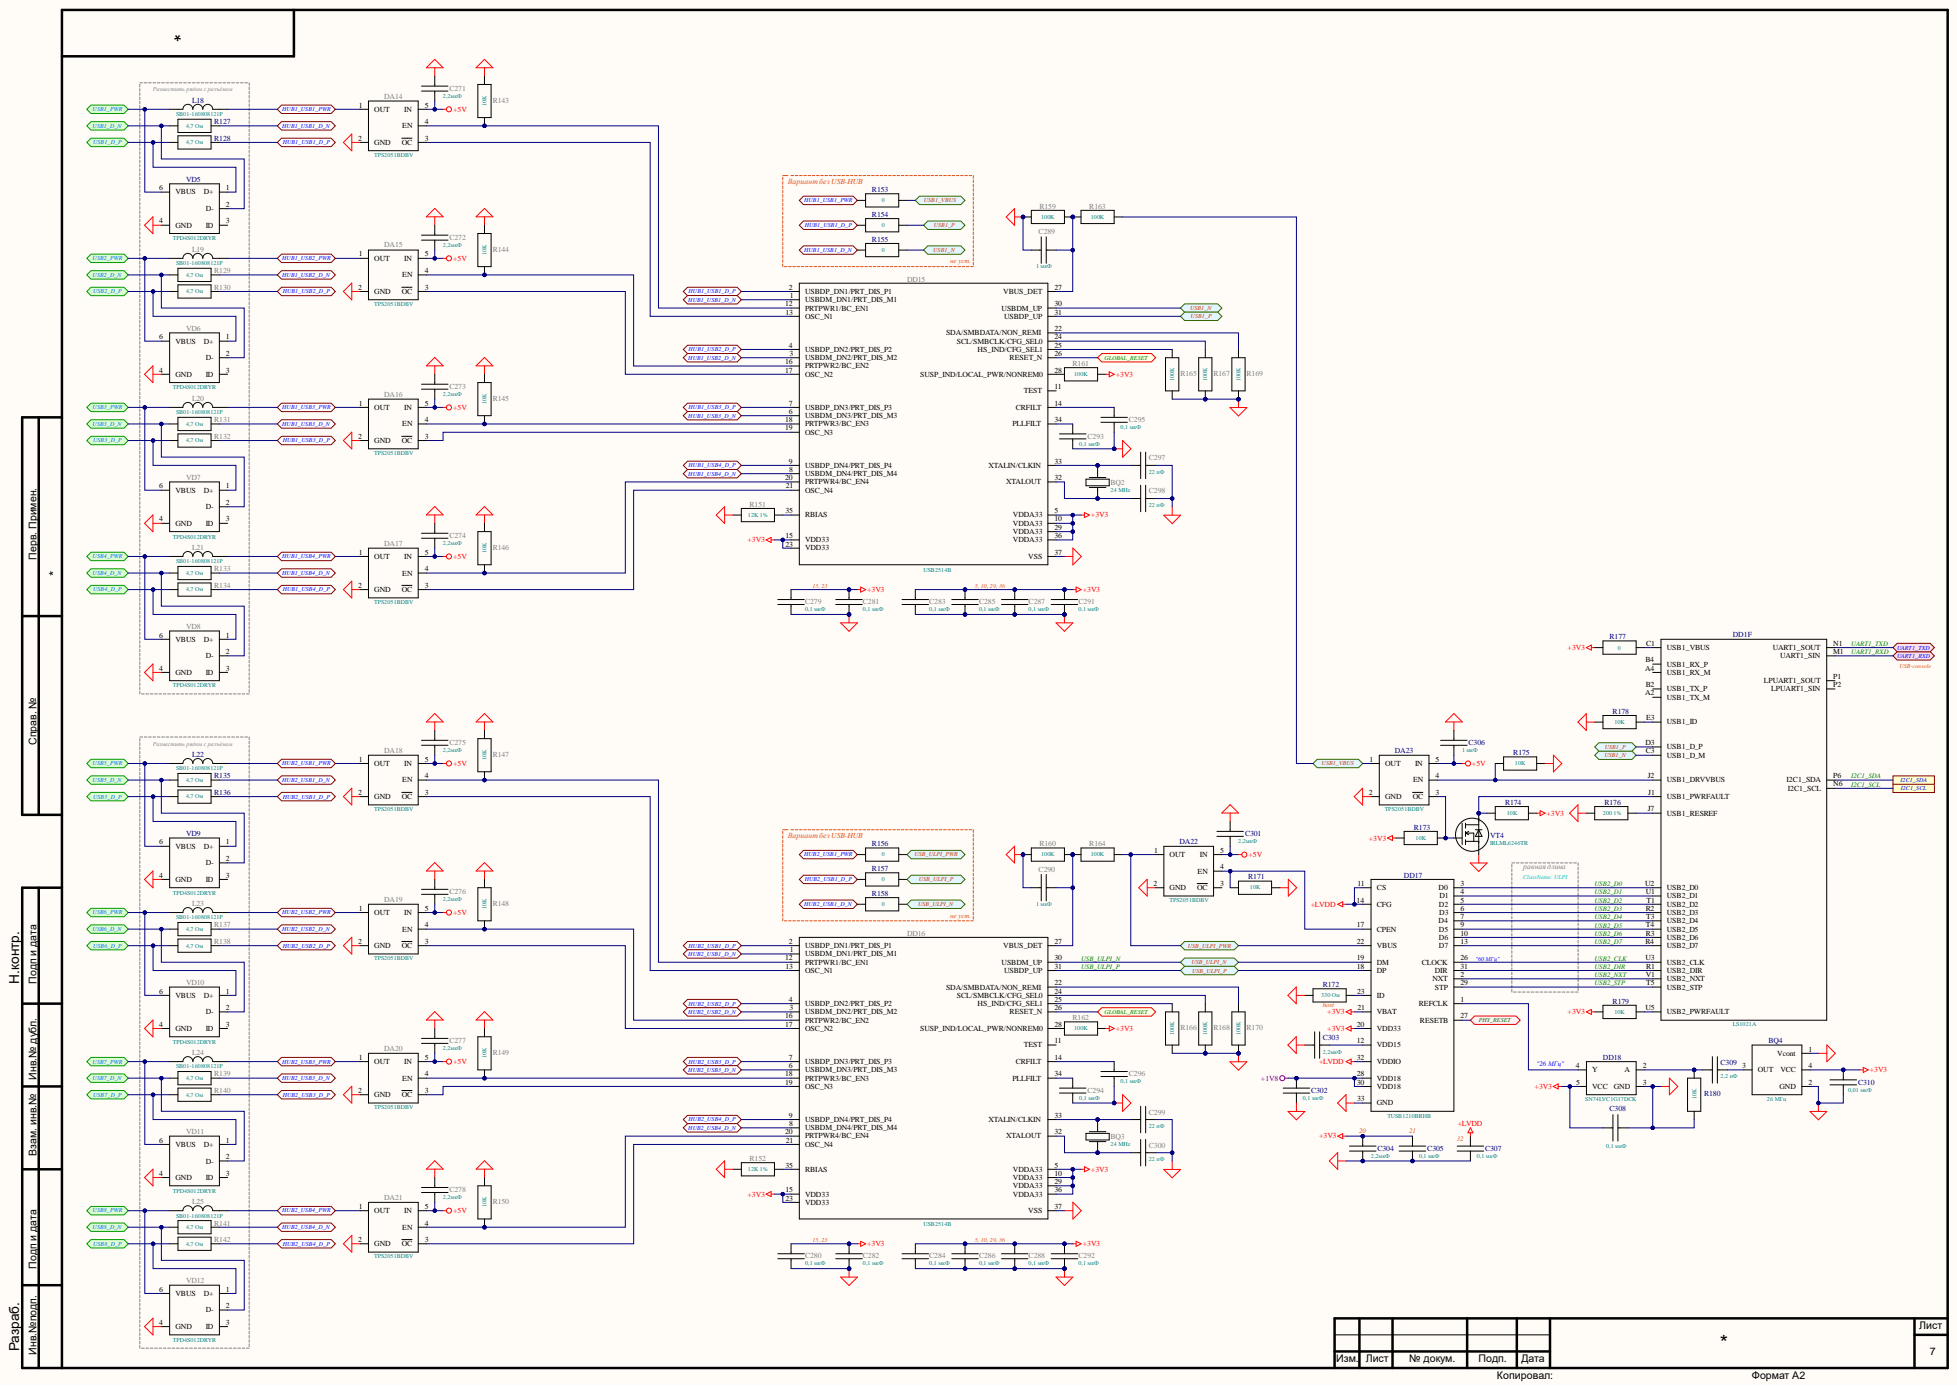
[picture p22: page 7]

HUB1 _USB1 _D_N | 1 | 3 0

HUB1 _USB2 _D_ P HUB1 _USB2 _D_N | 4 | 2 2

Подп и дата Перв. Примен. Справ. №

Инв.№подп. Инв.№ дубл. Подп и дата Взам. инв.№

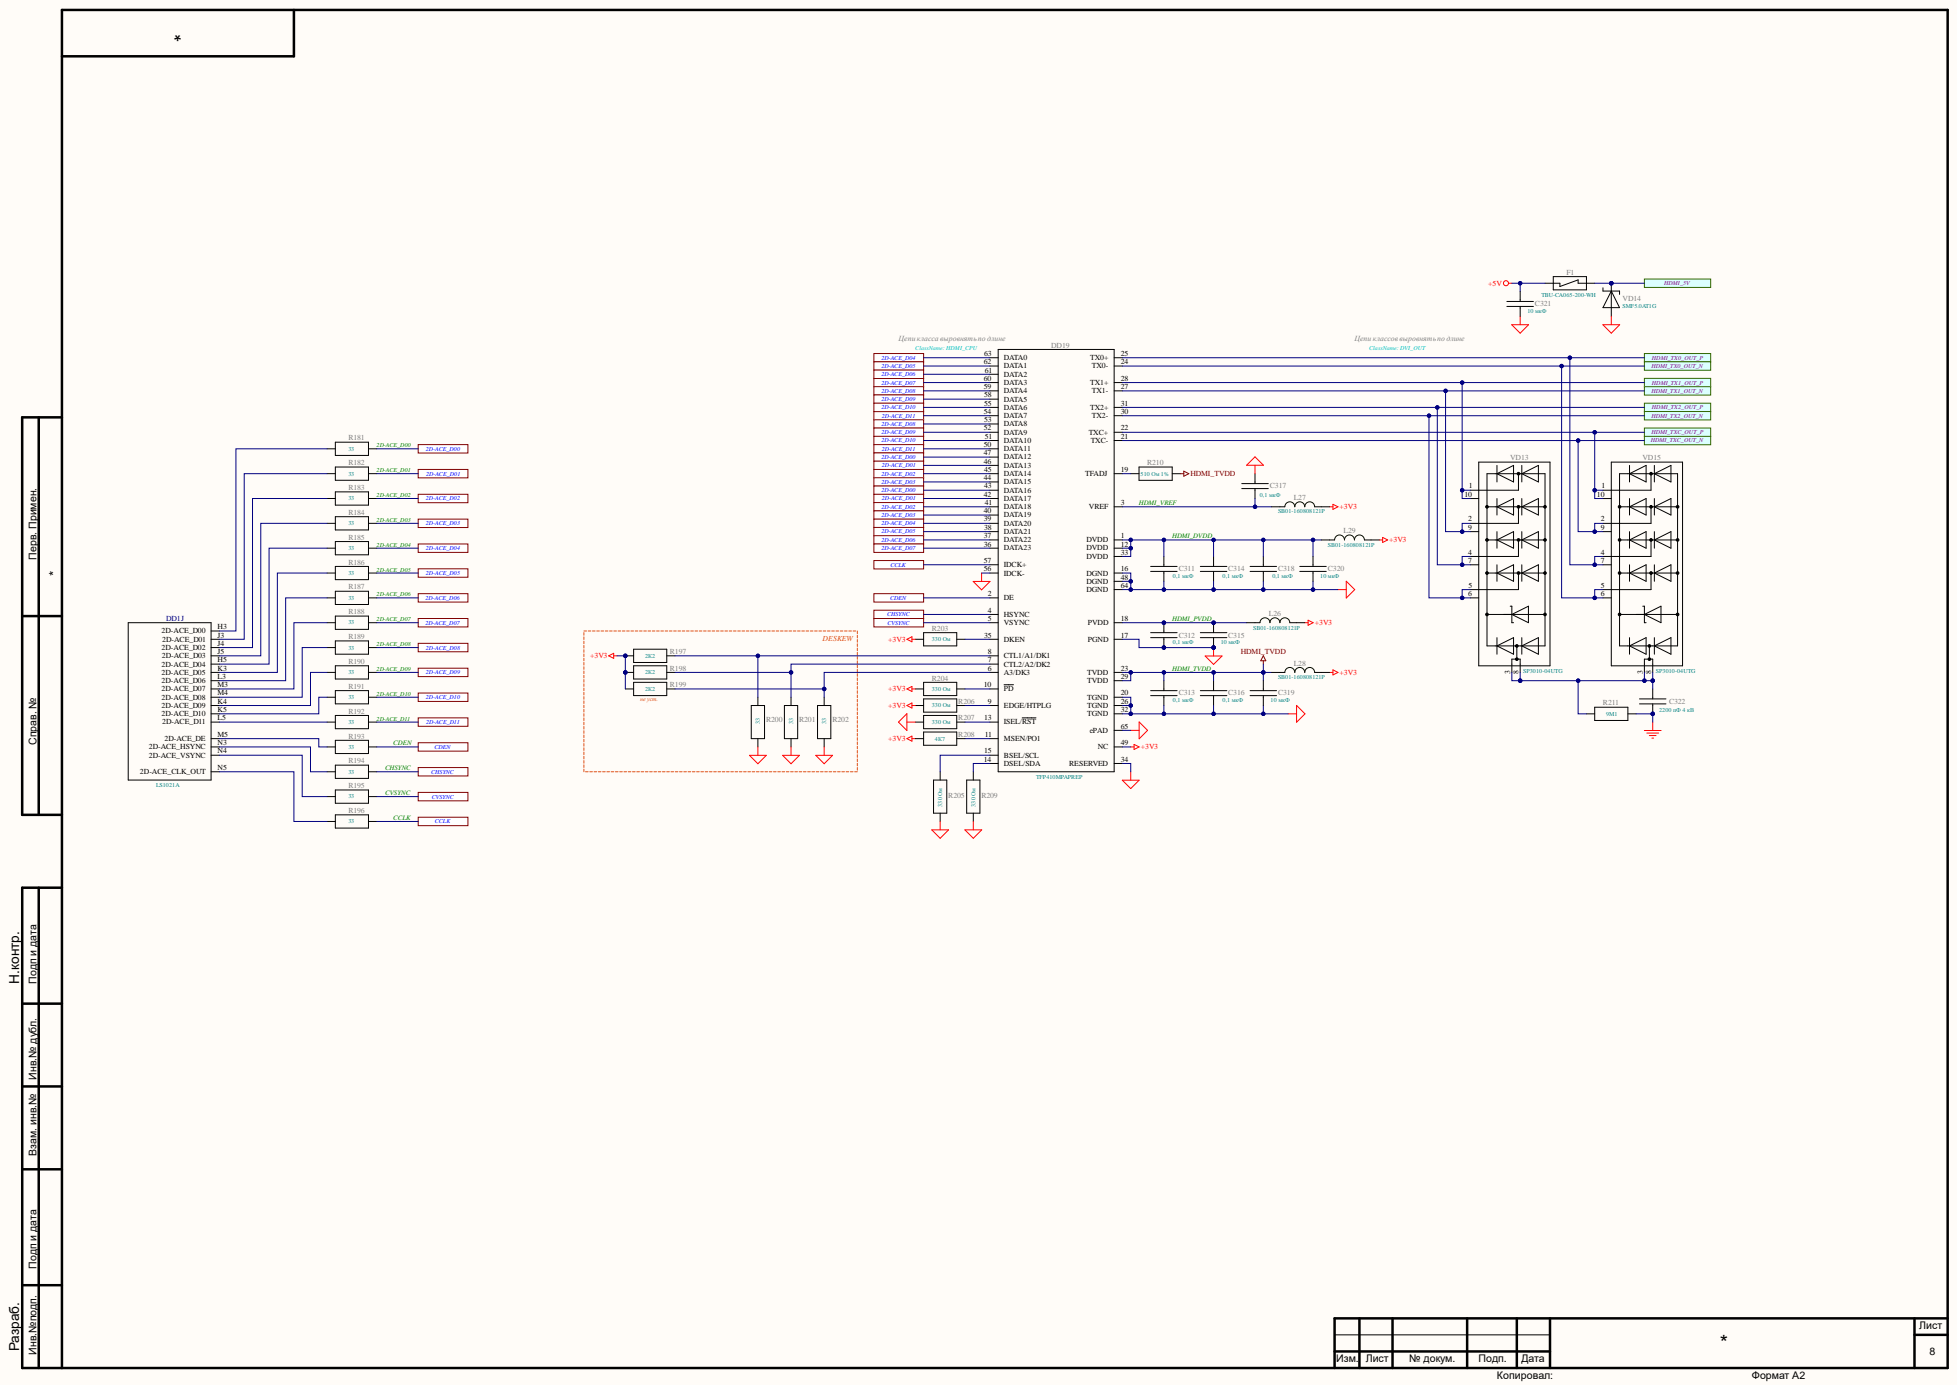
[picture p23: page 8]

Подп и дата Перв. Примен. Справ. №

Инв.№подп. Инв.№ дубл. Подп и дата Взам. инв.№

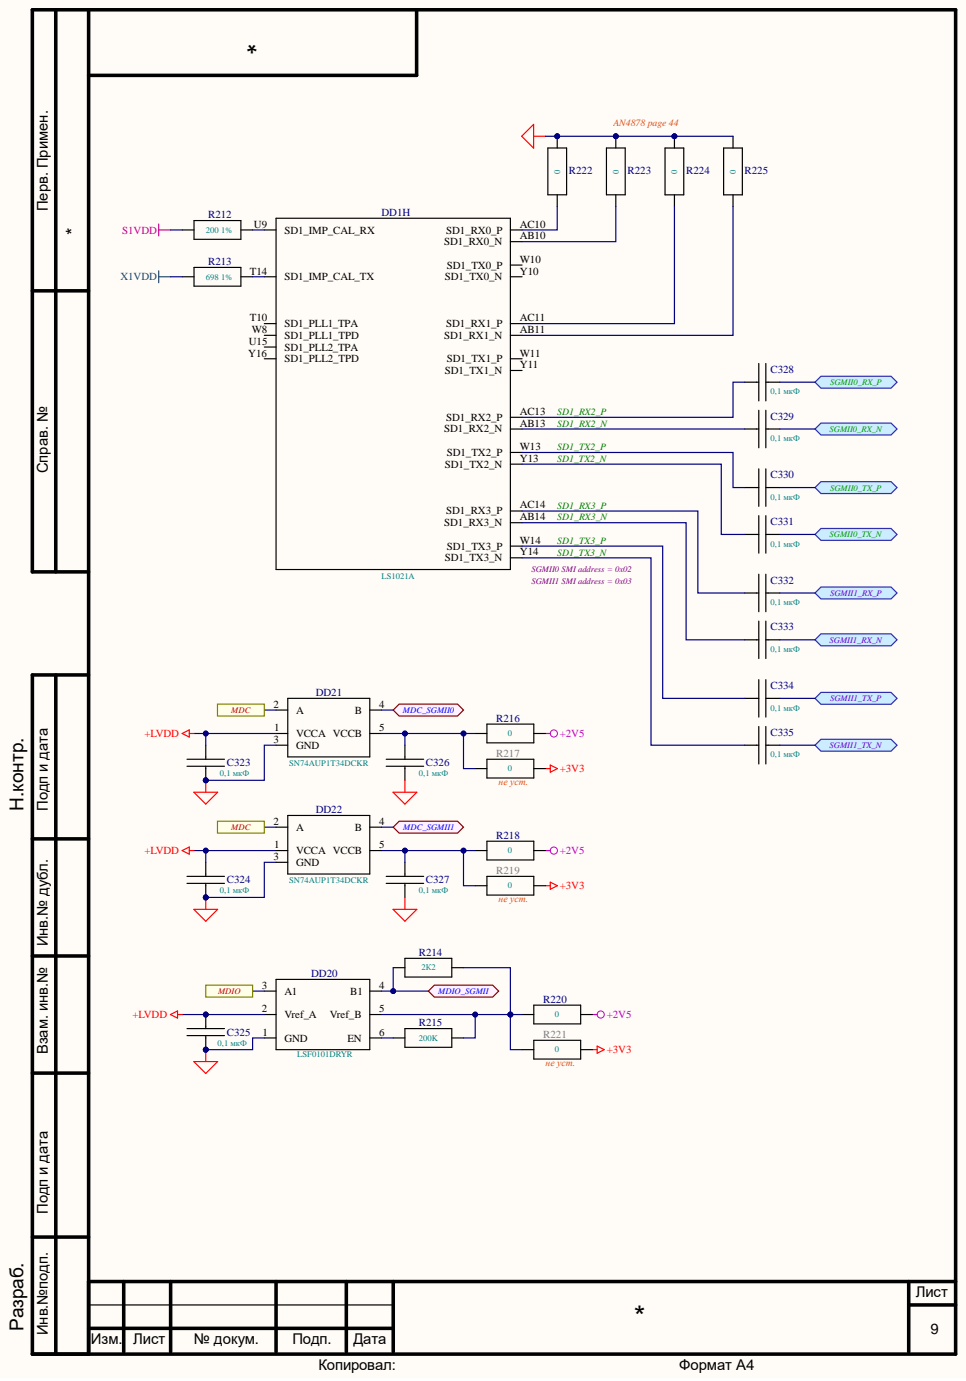
[picture p24: page 9]

Подп и дата Перв. Примен. Справ. №

Инв.№подп. Инв.№ дубл. Подп и дата Взам. инв.№

MDIO | Vref_A 2

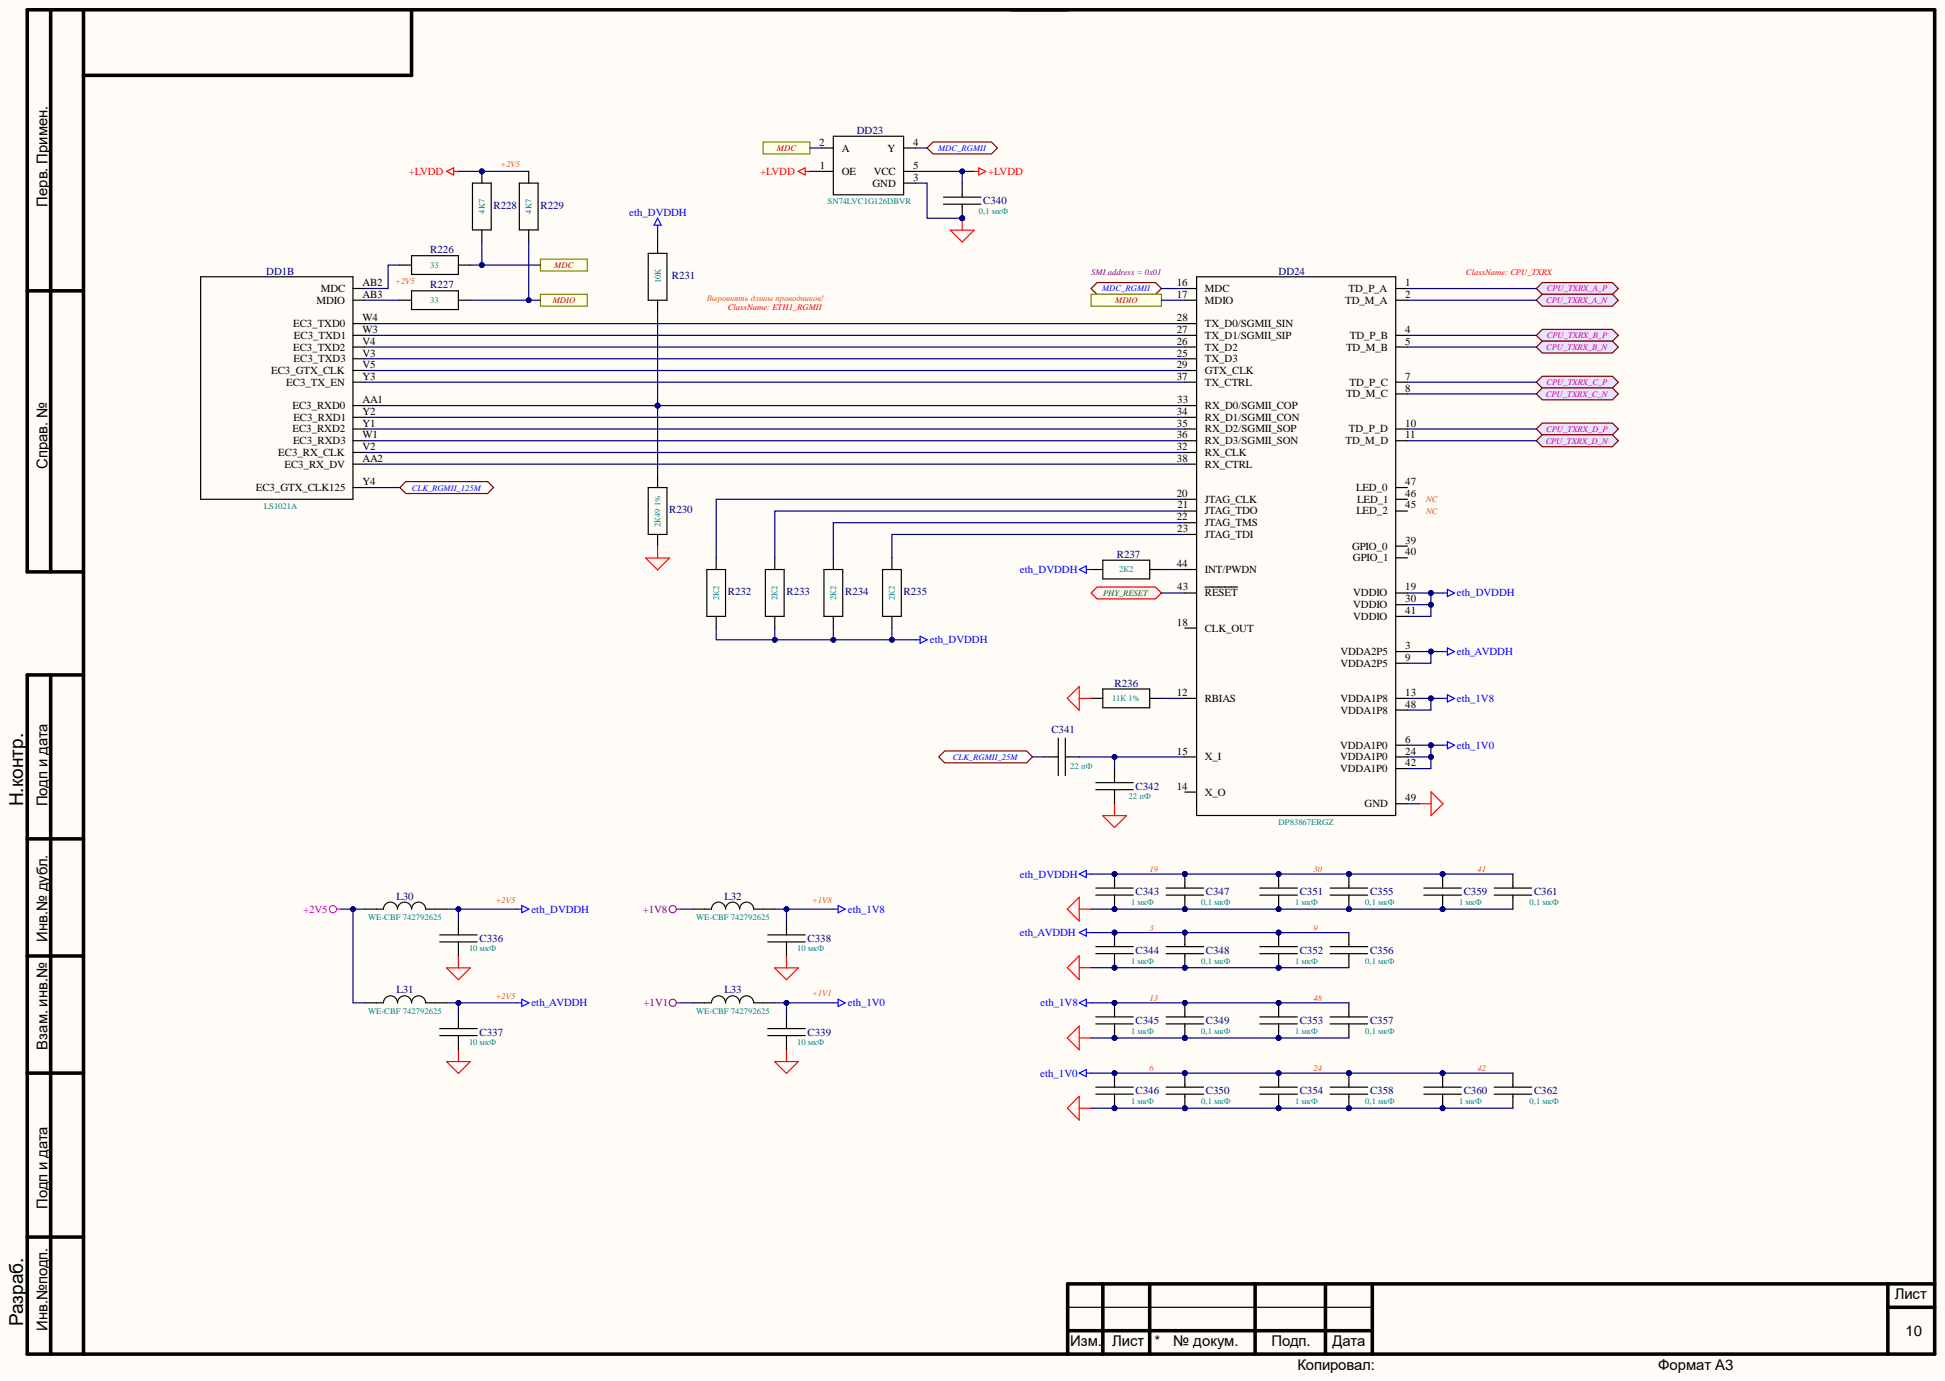
[picture p25: page 10]

Подп и дата Перв. Примен. Справ. №

MDC | OE 1

JTAG_TMS 22

R237 | INT/PWDN 44

Инв.№подп. Инв.№ дубл. Подп и дата Взам. инв.№

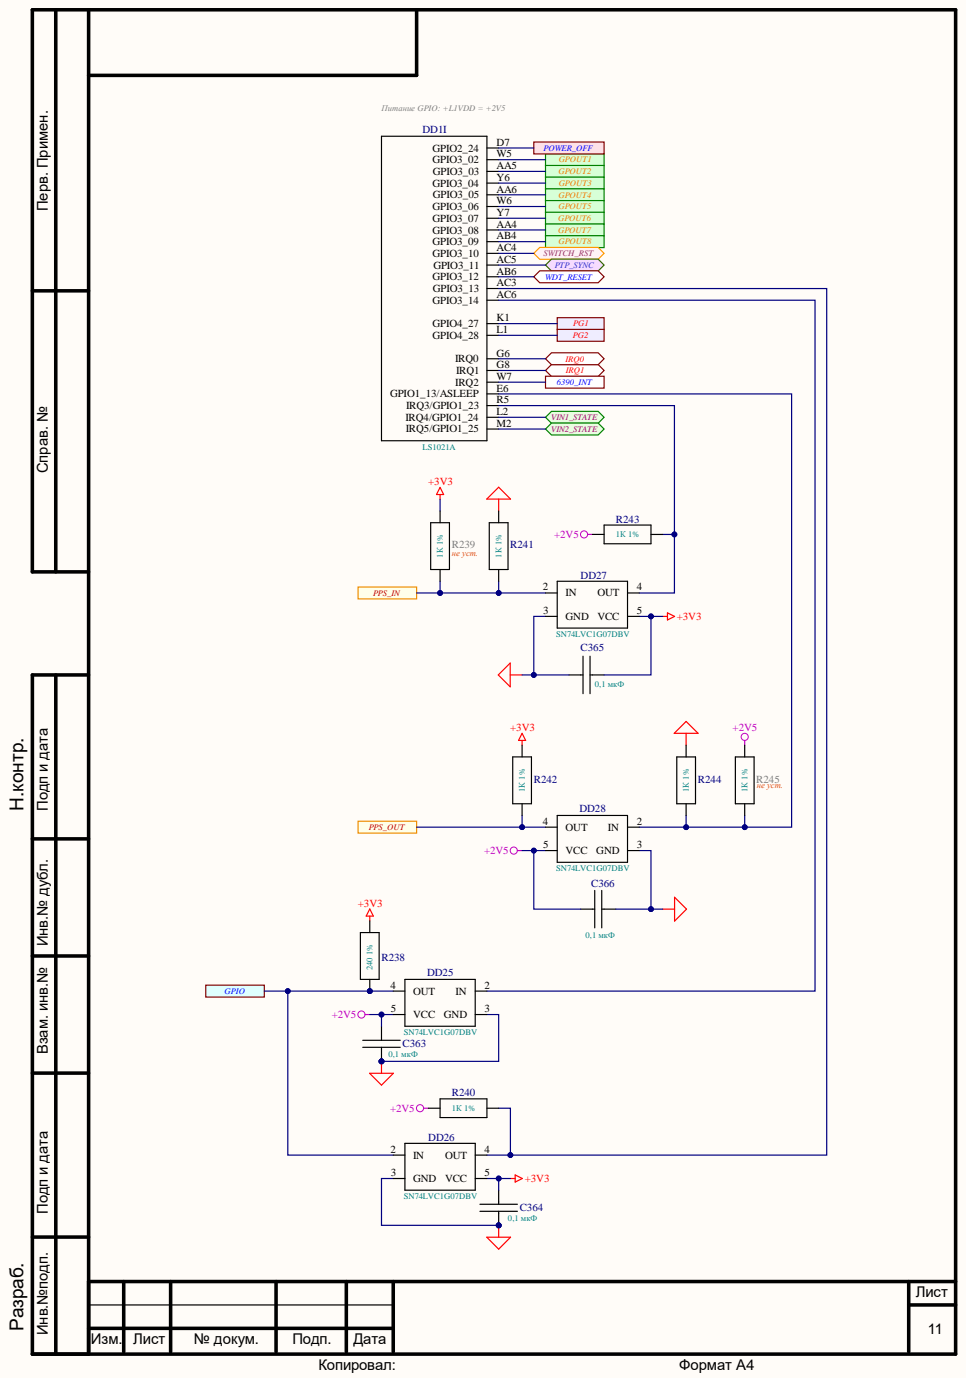
[picture p26: page 11]

Подп и дата Перв. Примен. Справ. №

Инв.№подп. Инв.№ дубл. Подп и дата Взам. инв.№

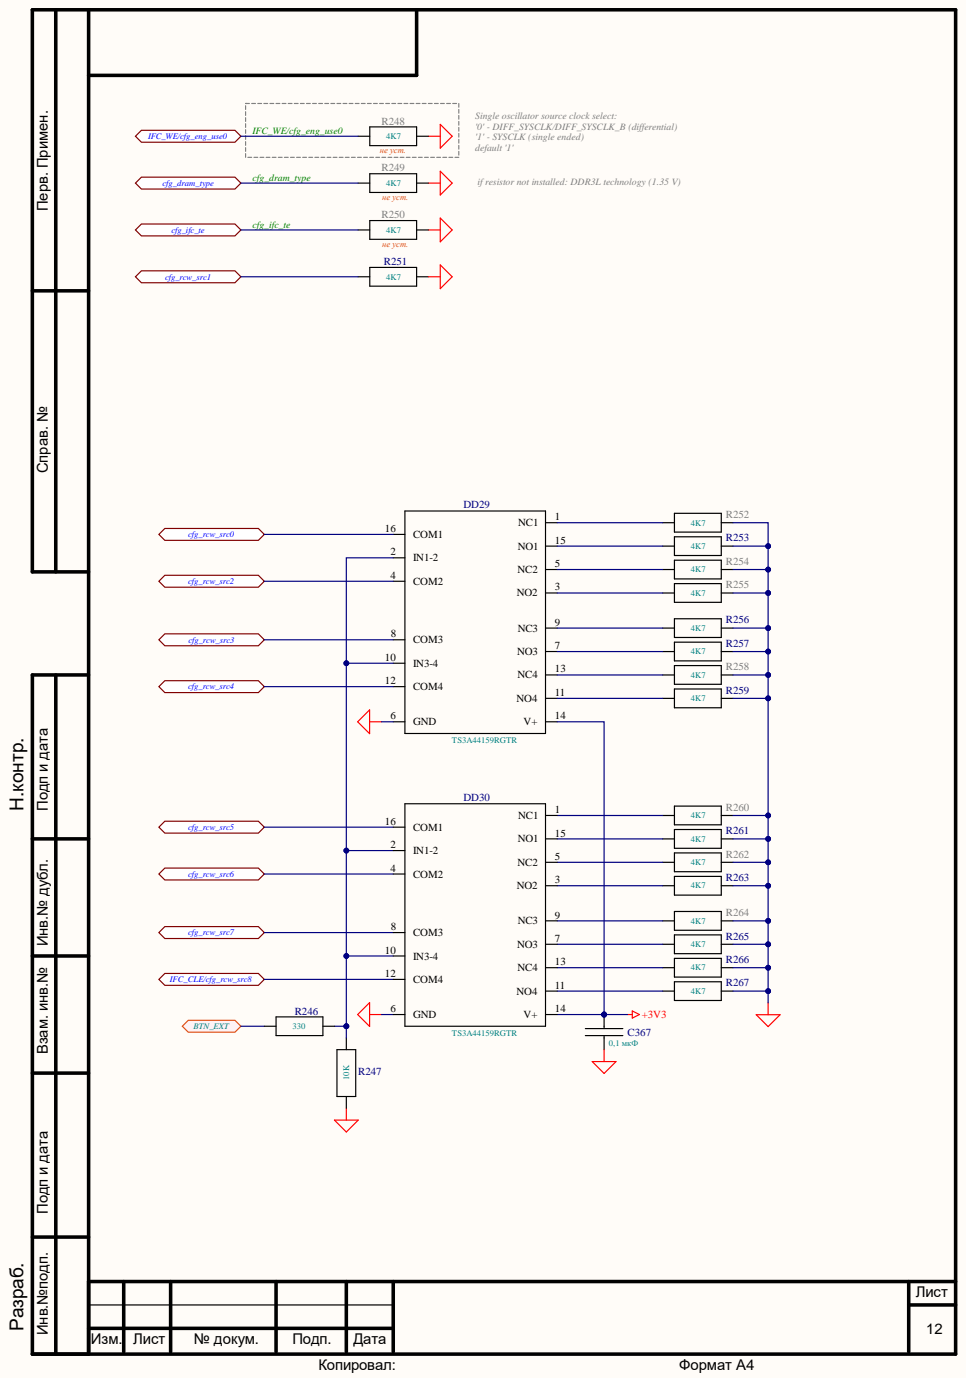
[picture p27: page 12]

Подп и дата Перв. Примен. Справ. №

Single oscillator source clock select:
'0' - DIFF_SYSCLK/DIFF_SYSCLK_B (differential)
'1' - SYSCLK (single ended)
default '1'

if resistor not installed: DDR3L technology (1.35 V)

Инв.№подп. Инв.№ дубл. Подп и дата Взам. инв.№

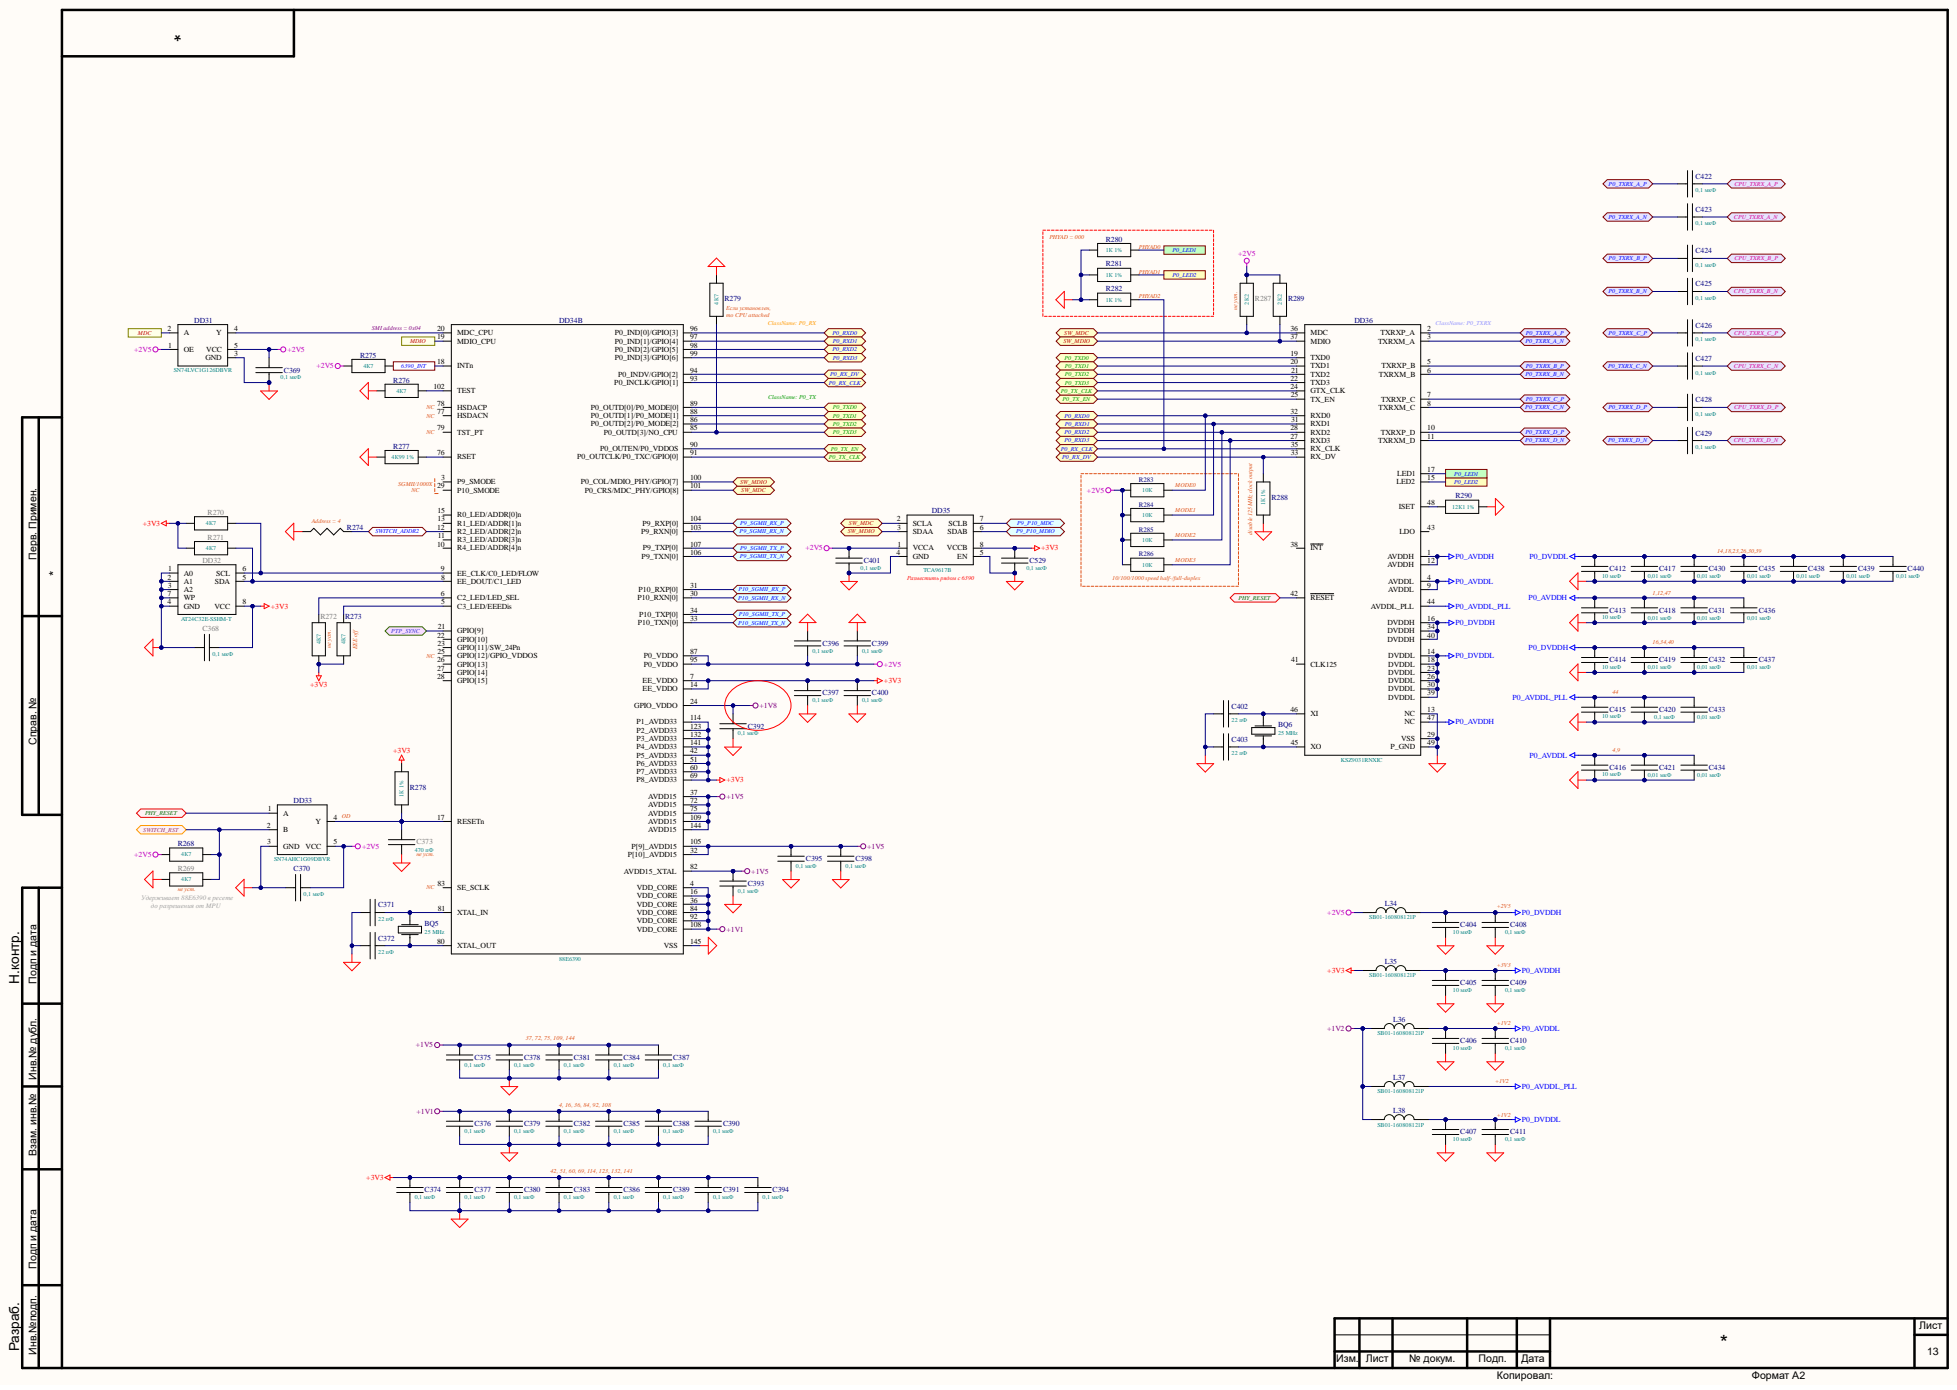
[picture p28: page 13]

Подп и дата Перв. Примен. Справ. №

10/100/1000 speed half-/full-duplex

Удерживает 88E6390 в ресете
до разрешения от MPU

Инв.№подп. Инв.№ дубл. Подп и дата Взам. инв.№

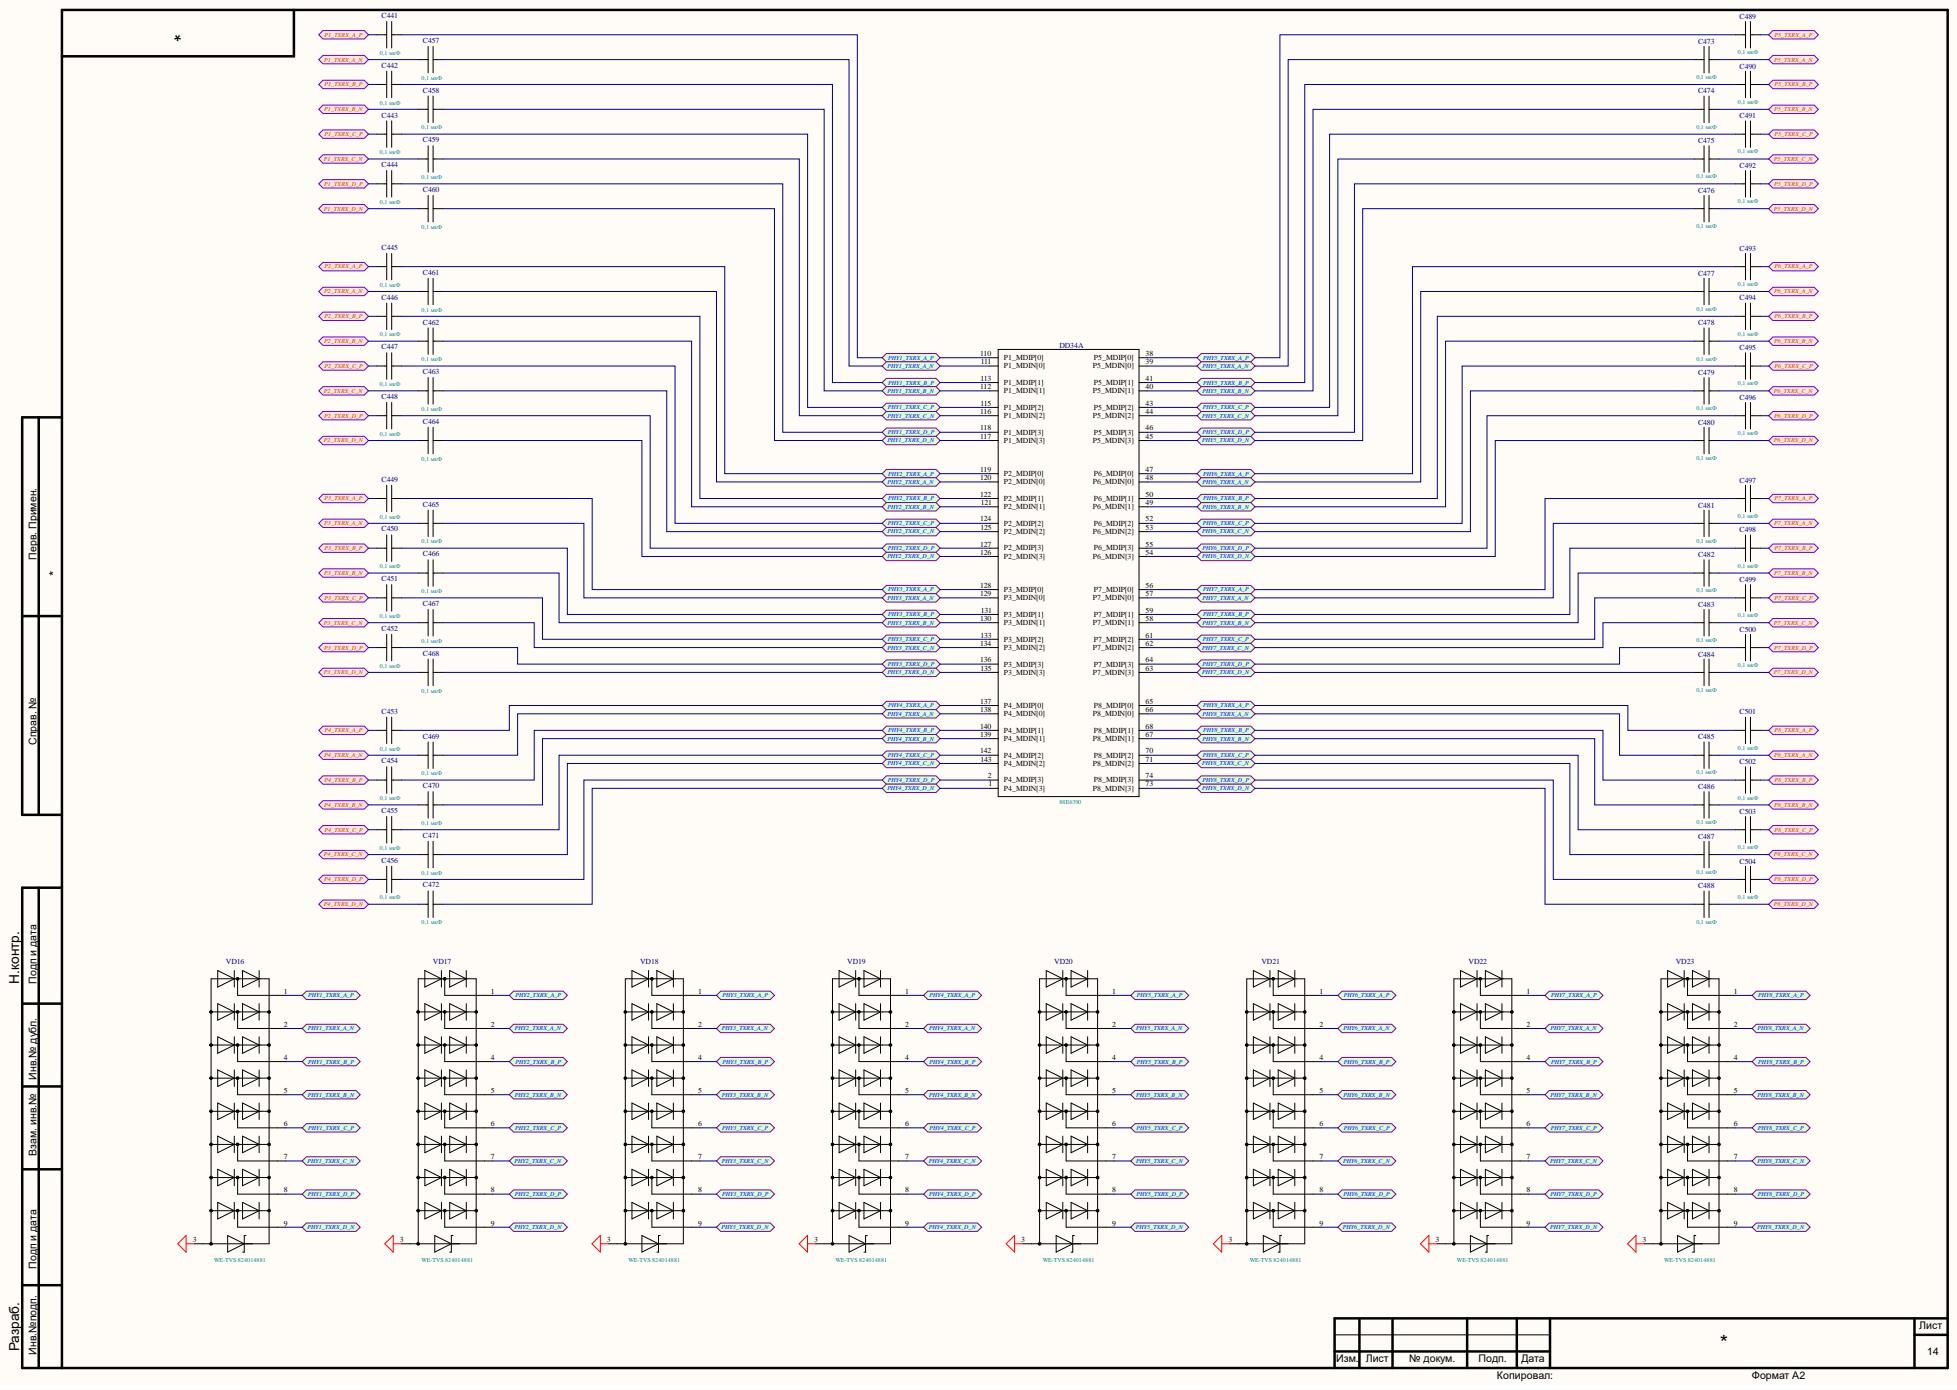
[picture p29: page 14]

0,1 мкФ

Подп и дата Перв. Примен. Справ. №

Инв.№подп. Инв.№ дубл. Подп и дата Взам. инв.№

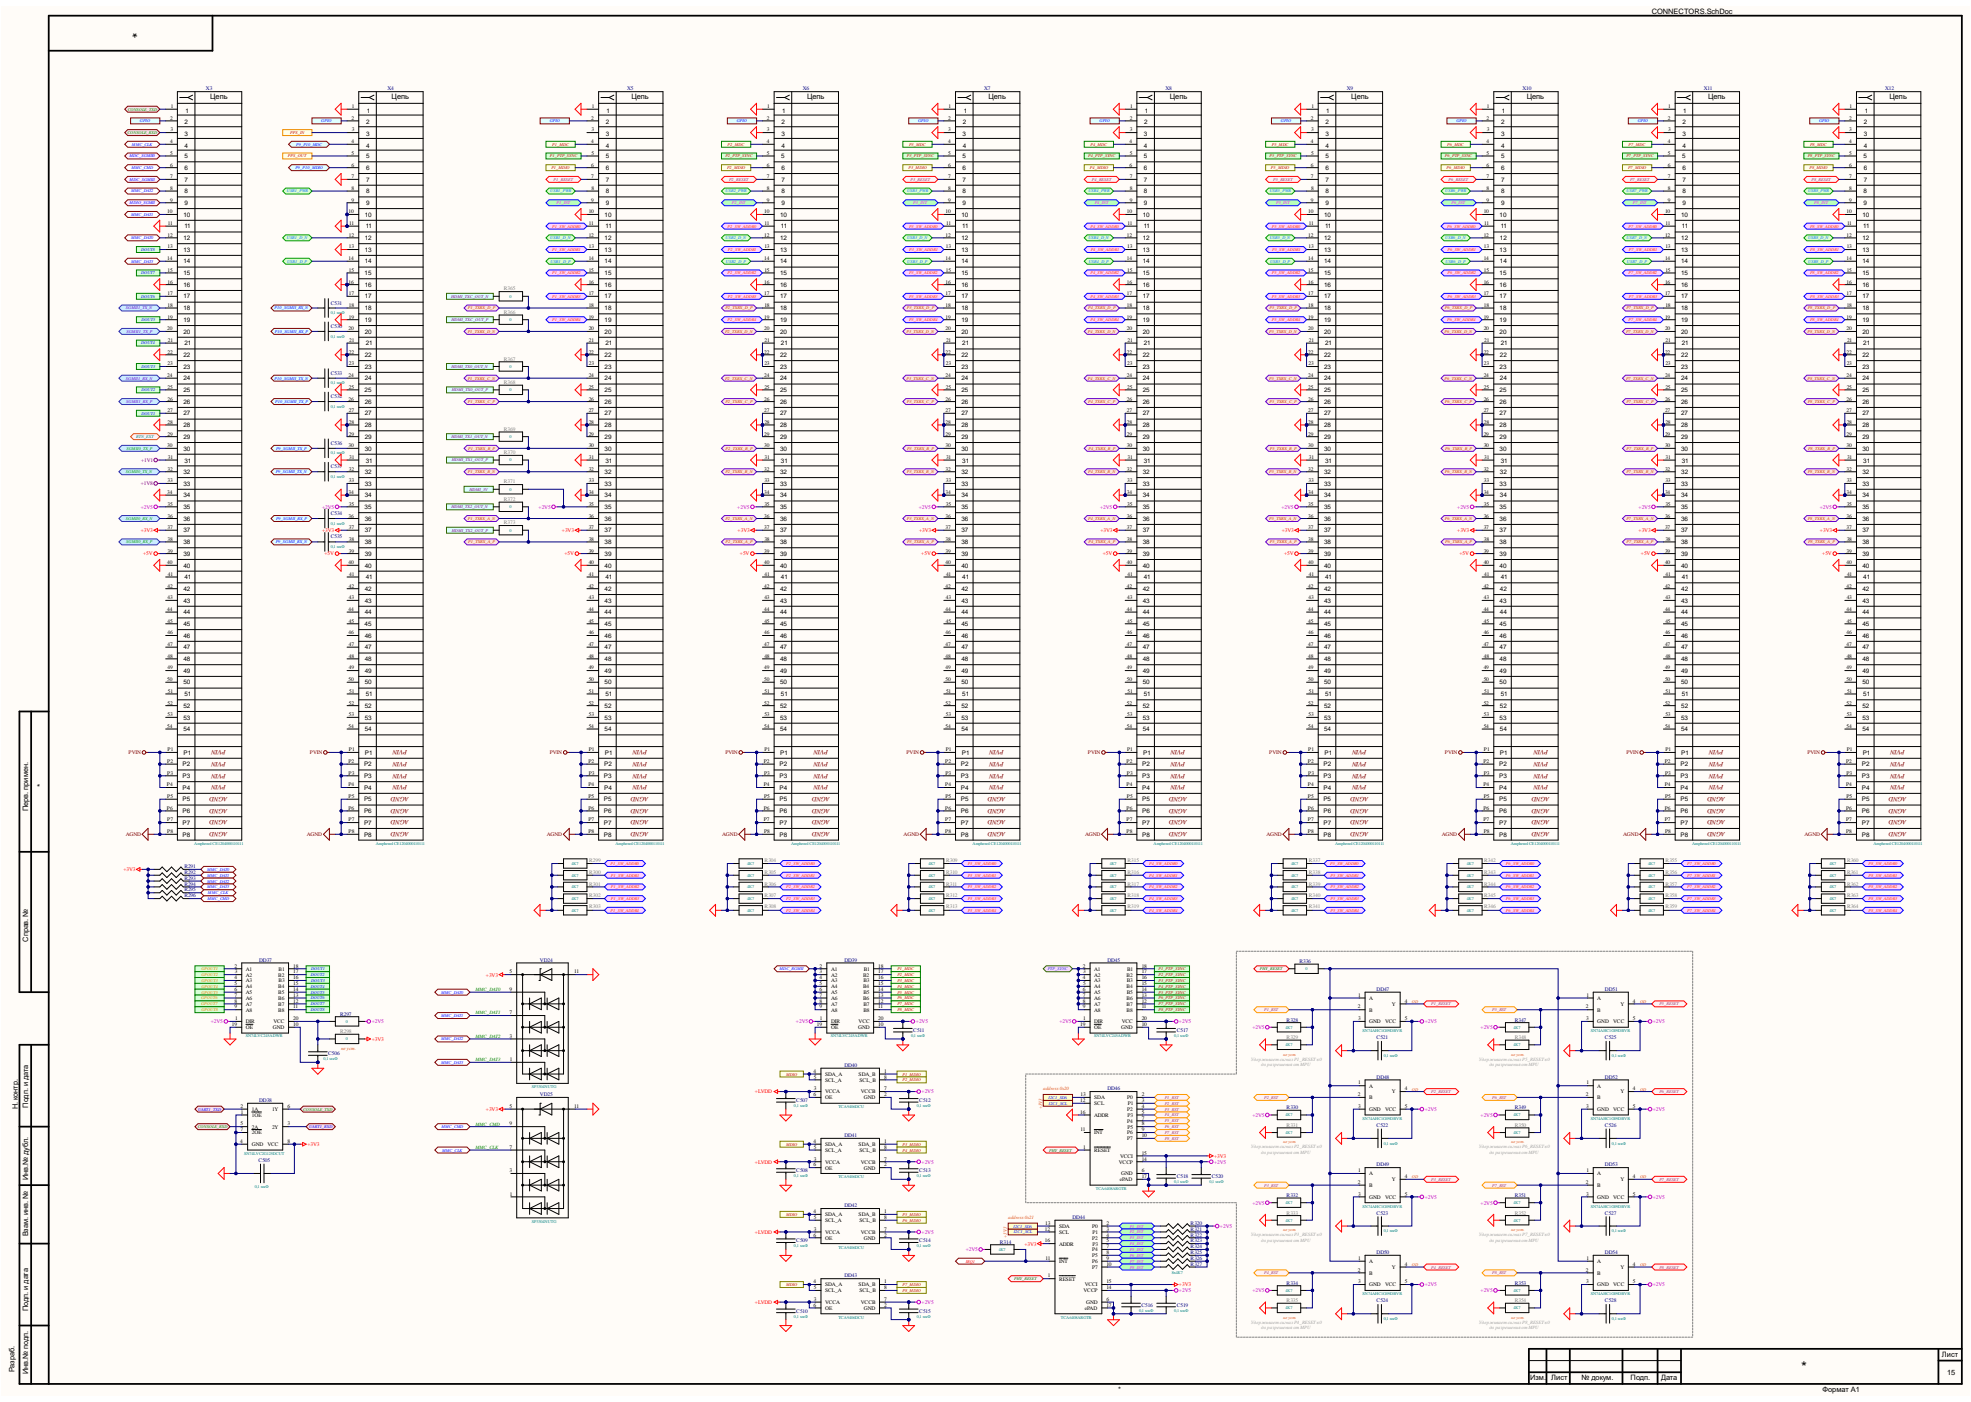
[picture p30: page 15]

Подп. и дата Перв. примен. Справ. №

Удерживает сигналP1_RESET в 0
до разрешения от MPU

Удерживает сигналP5_RESET в 0

Инв.№ подп. Инв.№ дубл. Подп. и дата Взам. инв. №

Удерживает сигналP2_RESET в 0

Удерживает сигналP6_RESET в 0

Удерживает сигналP3_RESET в 0

Удерживает сигналP7_RESET в 0

Удерживает сигналP4_RESET в 0

Удерживает сигналP8_RESET в 0
