UrbanSmartGrid/IRON_CASE_SWITCH/HW/PCB_PROJECTS/LEGACY/SWITCH_34/Version1/MOTHER_BOARD/Схема адресации MDIO.pdf

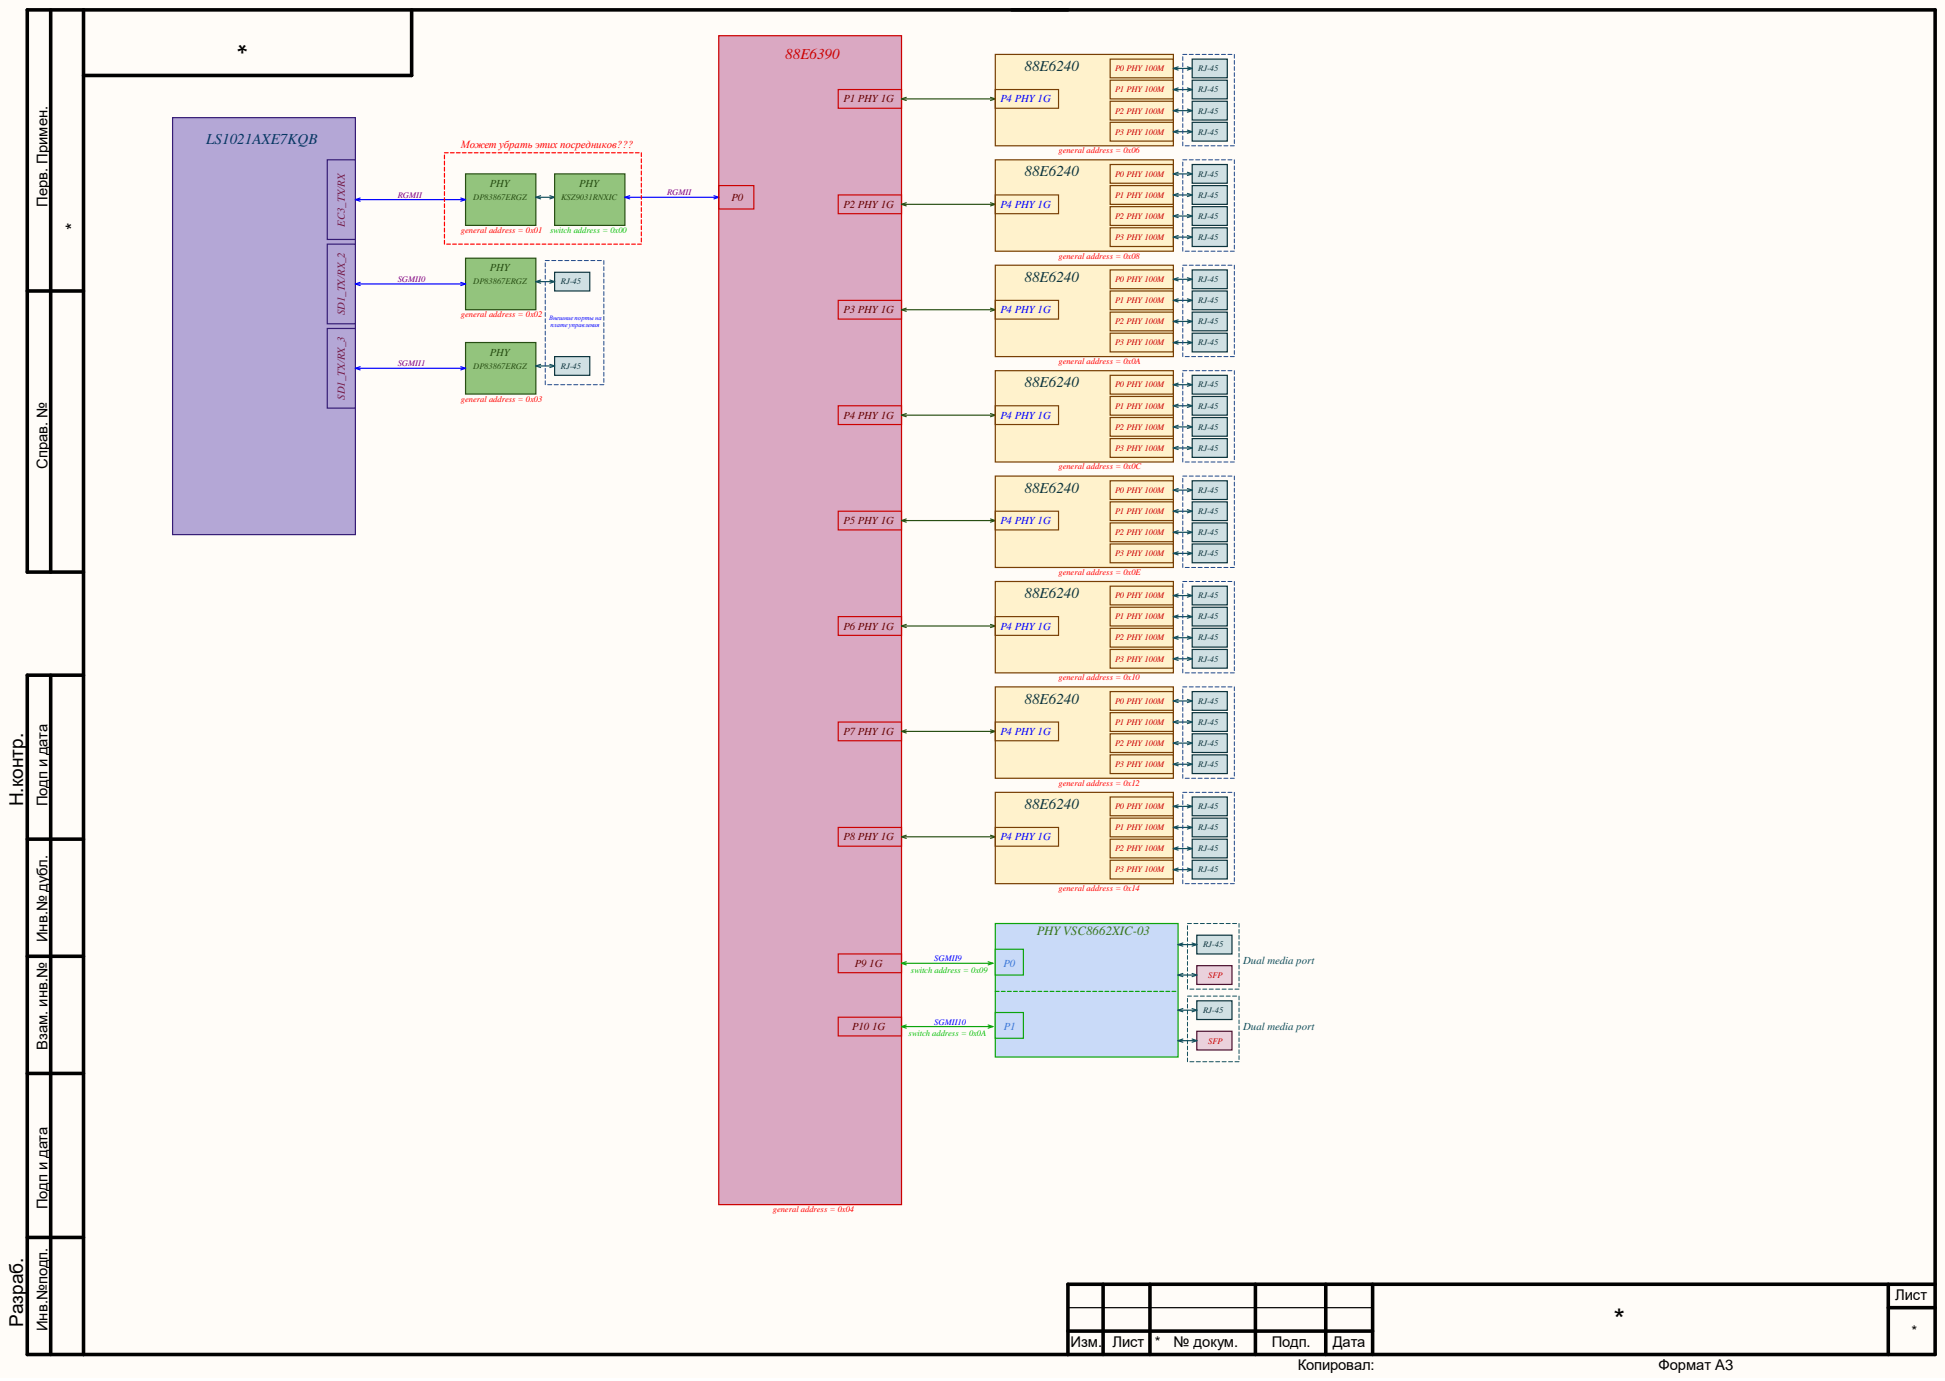
[picture p31: page 1]

Подп и дата Перв. Примен. Справ. №

Может убрать этих посредников???

Инв.№подп. Инв.№ дубл. Подп и дата Взам. инв.№
