UrbanSmartGrid/IRON_CASE_SWITCH/(list of files, drawings)

Other design files:
HW/PCB_PROJECTS/ACTUAL/MODULE_CPU_MX240/MODULE_CPU_MX240_V1.0/MODULE_CPU_MX240_V1.0/CONNECTOR.SchDoc
HW/PCB_PROJECTS/ACTUAL/MODULE_CPU_MX240/MODULE_CPU_MX240_V1.0/MODULE_CPU_MX240_V1.0/CONSOLE.SchDoc
HW/PCB_PROJECTS/ACTUAL/MODULE_CPU_MX240/MODULE_CPU_MX240_V1.0/MODULE_CPU_MX240_V1.0/DDR3.SchDoc
HW/PCB_PROJECTS/ACTUAL/MODULE_CPU_MX240/MODULE_CPU_MX240_V1.0/MODULE_CPU_MX240_V1.0/ETHERNET.SchDoc
HW/PCB_PROJECTS/ACTUAL/MODULE_CPU_MX240/MODULE_CPU_MX240_V1.0/MODULE_CPU_MX240_V1.0/ETHERNET_CONTROL.SchDoc
HW/PCB_PROJECTS/ACTUAL/MODULE_CPU_MX240/MODULE_CPU_MX240_V1.0/MODULE_CPU_MX240_V1.0/FLASH.SchDoc
HW/PCB_PROJECTS/ACTUAL/MODULE_CPU_MX240/MODULE_CPU_MX240_V1.0/MODULE_CPU_MX240_V1.0/MODULE_CPU_MX240_V1.0.PrjPcb
HW/PCB_PROJECTS/ACTUAL/MODULE_CPU_MX240/MODULE_CPU_MX240_V1.0/MODULE_CPU_MX240_V1.0/MODULE_CPU_MX240_V1.0_TEST.PcbDoc
HW/PCB_PROJECTS/ACTUAL/MODULE_CPU_MX240/MODULE_CPU_MX240_V1.0/MODULE_CPU_MX240_V1.0/MPU.SchDoc
HW/PCB_PROJECTS/ACTUAL/MODULE_CPU_MX240/MODULE_CPU_MX240_V1.0/MODULE_CPU_MX240_V1.0/MPU_POWER.SchDoc
HW/PCB_PROJECTS/ACTUAL/MODULE_CPU_MX240/MODULE_CPU_MX240_V1.0/MODULE_CPU_MX240_V1.0/POWER.SchDoc
HW/PCB_PROJECTS/ACTUAL/MODULE_CPU_MX240/MODULE_CPU_MX240_V1.0/MODULE_CPU_MX240_V1.0/RELE.SchDoc
HW/PCB_PROJECTS/ACTUAL/MOTHER_BOARD/MOTHER_BOARD_V1.0/BMC.SchDoc
HW/PCB_PROJECTS/ACTUAL/MOTHER_BOARD/MOTHER_BOARD_V1.0/BMC_MILANDR.SchDoc
HW/PCB_PROJECTS/ACTUAL/MOTHER_BOARD/MOTHER_BOARD_V1.0/CONNECTORS.SchDoc
HW/PCB_PROJECTS/ACTUAL/MOTHER_BOARD/MOTHER_BOARD_V1.0/INPUT_FROM_CPU.SchDoc
HW/PCB_PROJECTS/ACTUAL/MOTHER_BOARD/MOTHER_BOARD_V1.0/MOTHER_BOARD_V1.0.PrjPcb
HW/PCB_PROJECTS/ACTUAL/MOTHER_BOARD/MOTHER_BOARD_V1.0/MOTHER_BOARD_V1.0_TEST.PcbDoc
HW/PCB_PROJECTS/ACTUAL/MOTHER_BOARD/MOTHER_BOARD_V1.0/POWER_DISCRETE.SchDoc
HW/PCB_PROJECTS/ACTUAL/MOTHER_BOARD/MOTHER_BOARD_V1.0/POWER_INPUT.SchDoc
HW/PCB_PROJECTS/ACTUAL/MOTHER_BOARD/MOTHER_BOARD_V1.0/SWITCH.SchDoc
HW/PCB_PROJECTS/ACTUAL/MOTHER_BOARD/MOTHER_BOARD_V1.0/SWITCH_P1_P8.SchDoc
HW/PCB_PROJECTS/ACTUAL/POWER_HOT_SWAP/PCB PROJECT/POWER_HOT_SWAP/POWER_HOT_SWAP.PcbDoc
HW/PCB_PROJECTS/ACTUAL/POWER_HOT_SWAP/PCB PROJECT/POWER_HOT_SWAP/POWER_HOT_SWAP.PrjPcb
HW/PCB_PROJECTS/ACTUAL/POWER_HOT_SWAP/PCB PROJECT/POWER_HOT_SWAP/POWER_HOT_SWAP.SchDoc
HW/PCB_PROJECTS/LEGACY/SWITCH_34/Version1/MODULE_2x1G_DUAL_MEDIA/CONNECTOR.SchDoc
HW/PCB_PROJECTS/LEGACY/SWITCH_34/Version1/MODULE_2x1G_DUAL_MEDIA/CONTROL.SchDoc
HW/PCB_PROJECTS/LEGACY/SWITCH_34/Version1/MODULE_2x1G_DUAL_MEDIA/MODULE_2x1G_DUAL_MEDIA_V1.0.PrjPcb
HW/PCB_PROJECTS/LEGACY/SWITCH_34/Version1/MODULE_2x1G_DUAL_MEDIA/PORT0.SchDoc
HW/PCB_PROJECTS/LEGACY/SWITCH_34/Version1/MODULE_2x1G_DUAL_MEDIA/PORT1.SchDoc
HW/PCB_PROJECTS/LEGACY/SWITCH_34/Version1/MODULE_2x1G_DUAL_MEDIA/POWER.SchDoc
HW/PCB_PROJECTS/LEGACY/SWITCH_34/Version1/MODULE_4x100_Fx/CONNECTOR.SchDoc
HW/PCB_PROJECTS/LEGACY/SWITCH_34/Version1/MODULE_4x100_Fx/CONTROL.SchDoc
HW/PCB_PROJECTS/LEGACY/SWITCH_34/Version1/MODULE_4x100_Fx/MODULE_4x100_Fx_V1.0.PrjPcb
HW/PCB_PROJECTS/LEGACY/SWITCH_34/Version1/MODULE_4x100_Fx/P0_DUAL_MEDIA.SchDoc
HW/PCB_PROJECTS/LEGACY/SWITCH_34/Version1/MODULE_4x100_Fx/P1_DUAL_MEDIA.SchDoc
HW/PCB_PROJECTS/LEGACY/SWITCH_34/Version1/MODULE_4x100_Fx/P2_DUAL_MEDIA.SchDoc
HW/PCB_PROJECTS/LEGACY/SWITCH_34/Version1/MODULE_4x100_Fx/P3_DUAL_MEDIA.SchDoc
HW/PCB_PROJECTS/LEGACY/SWITCH_34/Version1/MODULE_4x100_Fx/POWER.SchDoc
HW/PCB_PROJECTS/LEGACY/SWITCH_34/Version1/MODULE_4x100_Fx/SWITCH.SchDoc
HW/PCB_PROJECTS/LEGACY/SWITCH_34/Version1/MODULE_4x100_RJ45/4x100_RJ45_OUTPUT.SchDoc
HW/PCB_PROJECTS/LEGACY/SWITCH_34/Version1/MODULE_4x100_RJ45/CONNECTOR.SchDoc
HW/PCB_PROJECTS/LEGACY/SWITCH_34/Version1/MODULE_4x100_RJ45/MODULE_4x100_RJ45_V1.0.PrjPcb
HW/PCB_PROJECTS/LEGACY/SWITCH_34/Version1/MODULE_4x100_RJ45/POWER.SchDoc
HW/PCB_PROJECTS/LEGACY/SWITCH_34/Version1/MODULE_4x100_RJ45/SWITCH.SchDoc
HW/PCB_PROJECTS/LEGACY/SWITCH_34/Version1/MODULE_CONTROL/CONNECTOR.SchDoc
HW/PCB_PROJECTS/LEGACY/SWITCH_34/Version1/MODULE_CONTROL/CONSOLE.SchDoc
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
