UrbanSmartGrid/IRON_CASE_SWITCH/SW/MODULE_4x100_Fx_SW/Core/Inc/main.h

#define SYS_RESET_Pin GPIO_PIN_13
#define SYS_RESET_GPIO_Port GPIOC
#define CS_P3_Pin GPIO_PIN_14
#define CS_P3_GPIO_Port GPIOC
#define CS_P0_Pin GPIO_PIN_15
#define CS_P0_GPIO_Port GPIOC
#define CS_P1_Pin GPIO_PIN_1
#define CS_P1_GPIO_Port GPIOA
#define CS_P2_Pin GPIO_PIN_2
#define CS_P2_GPIO_Port GPIOA
#define SCK_Pin GPIO_PIN_5
#define SCK_GPIO_Port GPIOA
#define MISO_Pin GPIO_PIN_6
#define MISO_GPIO_Port GPIOA
#define MOSI_Pin GPIO_PIN_7
#define MOSI_GPIO_Port GPIOA
