UrbanSmartGrid/IRON_CASE_SWITCH/(commit log)

2020-11-05 Start IRON_CASE_SWITCH porject
    [4x100_RJ45_OUTPUT.SchDoc, CONNECTOR.SchDoc, CONNECTORS.SchDoc, CONSOLE.SchDoc, CONTROL.SchDoc, DDR.SchDoc, ETHERNET.SchDoc, GNSS.SchDoc]
2021-01-07 Start New Ideology
    [INPUT_FROM_CPU.SchDoc, MOTHER_BOARD_V1.0.PrjPcb, MPU_SGMII_SATA.SchDoc, MPU_USB.SchDoc, POWER_DISCRETE.SchDoc, POWER_INPUT.SchDoc, SWITCH.SchDoc, SWITCH_CPU.SchDoc]
2021-01-13 Mother_Board complete
    [BMC.SchDoc, CONNECTORS.SchDoc, DDR.SchDoc, INPUT_FROM_CPU.SchDoc, MOTHER_BOARD_LS1021_v1.0.PrjPcb, MOTHER_BOARD_V1.0.PrjPcb, MPU_CONTROL.SchDoc, MPU_GND.SchDoc]
2021-01-14 Start MODULE_CPU_MX240_V1.0
    [CONNECTORS.SchDoc, MODULE_CPU_MX240_V1.0.PrjPcb, MPU.SchDoc, MPU_POWER.SchDoc, POWER.SchDoc]
2021-01-16 Til Ethernet
    [CONSOLE.SchDoc, DDR3.SchDoc, ETHERNET.SchDoc, ETHERNET_CONTROL.SchDoc, FLASH.SchDoc, MODULE_CPU_MX240_V1.0.PrjPcb, MPU.SchDoc, POWER.SchDoc]
2021-01-18 Continue Ethernet
    [POWER.SchDoc, POWER_INPUT.SchDoc]
2021-01-18 Add RS485
    [BMC.SchDoc, CONNECTORS.SchDoc, CONSOLE.SchDoc, DDR3.SchDoc, ETHERNET.SchDoc, ETHERNET_CONTROL.SchDoc, FLASH.SchDoc, MODULE_CPU_MX240_V1.0.PrjPcb]
2021-01-18 PoE Power Connectors
    [BMC.SchDoc, CONNECTORS.SchDoc, CONSOLE.SchDoc, DDR3.SchDoc, ETHERNET.SchDoc, ETHERNET_CONTROL.SchDoc, FLASH.SchDoc, MODULE_CPU_MX240_V1.0.PrjPcb]
2021-01-21 Add PoE connectors
    [CONNECTORS.SchDoc]
2021-01-21 Start Project POWER_HOT_SWAP
    [POWER_HOT_SWAP.PrjPcb, POWER_HOT_SWAP.SchDoc]
2021-01-21 POWER_HOT_SWAP Sch complete
    [POWER_HOT_SWAP.PrjPcb, POWER_HOT_SWAP.SchDoc]
2021-01-22 Progect POWER_HOT_SWAP complete
    [POWER_HOT_SWAP.PcbDoc, POWER_HOT_SWAP.PrjPcb, POWER_HOT_SWAP.SchDoc]
2021-01-27 ORing PoE power
    [BMC.SchDoc, CONNECTORS.SchDoc]
2021-02-01 Replace Milandr to STM32
    [BMC.SchDoc, BMC_MILANDR.SchDoc, MOTHER_BOARD_V1.0.PrjPcb, POWER_HOT_SWAP.PrjPcb]
2021-02-02 Start POWER_HOT_SWAP software project
    [POWER_HOT_SWAP.PcbDoc, POWER_HOT_SWAP.PrjPcb, POWER_HOT_SWAP.SchDoc]
2021-02-04 Power OR scheme
    [BMC.SchDoc, CONNECTORS.SchDoc, INPUT_FROM_CPU.SchDoc, POWER_DISCRETE.SchDoc, POWER_HOT_SWAP.PrjPcb, POWER_INPUT.SchDoc, SWITCH.SchDoc]
2021-02-05 Start MotherBoard footprint checking
    [BMC.SchDoc, CONNECTORS.SchDoc, INPUT_FROM_CPU.SchDoc, MOTHER_BOARD_V1.0.PrjPcb, POWER_DISCRETE.SchDoc, POWER_INPUT.SchDoc, SWITCH.SchDoc, SWITCH_P1_P8.SchDoc]
2021-02-05 Continue MotherBoard footprint chacking
    [BMC.SchDoc]
2021-02-06 Motherboard connectors rewiring
    [BMC.SchDoc, CONNECTORS.SchDoc, MOTHER_BOARD_LS1021_v1.0.PrjPcb, MOTHER_BOARD_LS1021_v1.0.SCHLIB, MOTHER_BOARD_V1.0.PrjPcb, POWER_HOT_SWAP.PrjPcb]
2021-02-17 MOTHER_BOARD_V1.0 scheme complete
    [CONNECTORS.SchDoc]
2021-02-21 Start placing MotherBoard
    [BMC.SchDoc, CONNECTORS.SchDoc, Copy of MOTHER_BOARD_V1.0_TEST.PcbDoc, INPUT_FROM_CPU.SchDoc, MOTHER_BOARD_V1.0.PrjPcb, POWER_DISCRETE.SchDoc, POWER_INPUT.SchDoc, SWITCH.SchDoc]
2021-02-27 MODULE_CPU_MX240_V1.0 scheme complete
    [BMC.SchDoc, CONNECTOR.SchDoc, CONNECTORS.SchDoc, CONSOLE.SchDoc, Copy of MOTHER_BOARD_V1.0_TEST.PcbDoc, DDR3.SchDoc, ETHERNET.SchDoc, ETHERNET_CONTROL.SchDoc]
2021-03-01 Start MODULE_CPU_MX240_V1.0 PCB
    [CONNECTOR.SchDoc, CONSOLE.SchDoc, ETHERNET.SchDoc, MODULE_CPU_MX240_V1.0.PrjPcb, MODULE_CPU_MX240_V1.0_TEST.PcbDoc, MPU.SchDoc]
2021-03-06 Fix BMC STM32F103RBT6
    [BMC.SchDoc, CONNECTORS.SchDoc, INPUT_FROM_CPU.SchDoc, POWER_DISCRETE.SchDoc, POWER_INPUT.SchDoc, SWITCH.SchDoc, SWITCH_P1_P8.SchDoc]
